SebastianCallh/kartoffel-tsea29/docs/src/anvandarhandledning.pdf

# Anv¨andarhandledning f¨or kartrobot

Patrik Sletmo
Version 1.0

Status

STATUS | Patrik Sletmo | 2016-12-DD

Kartrobot | 2016-12-13

# Projektidentitet

Grupp 3, 16/HT, KarToffel
Link¨opings tekniska h¨ogskola, ISY
Namn | Ansvar | Telefon | E-post
Patrik Sletmo | Projektledare | 070 783 57 61 | patsl736@student.liu.se
Rebecca Lindblom | Utvecklare | 073 436 40 79 | rebli156@student.liu.se
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
