SebastianCallh/kartoffel-tsea29/docs/src/images/robot.png

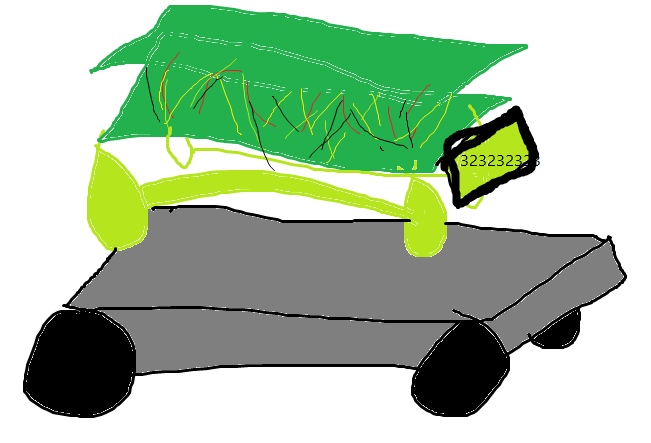
docs/src/images/robot.png
