SebastianCallh/kartoffel-tsea29/docs/src/mjukvaruklient_flowchart3.pdf

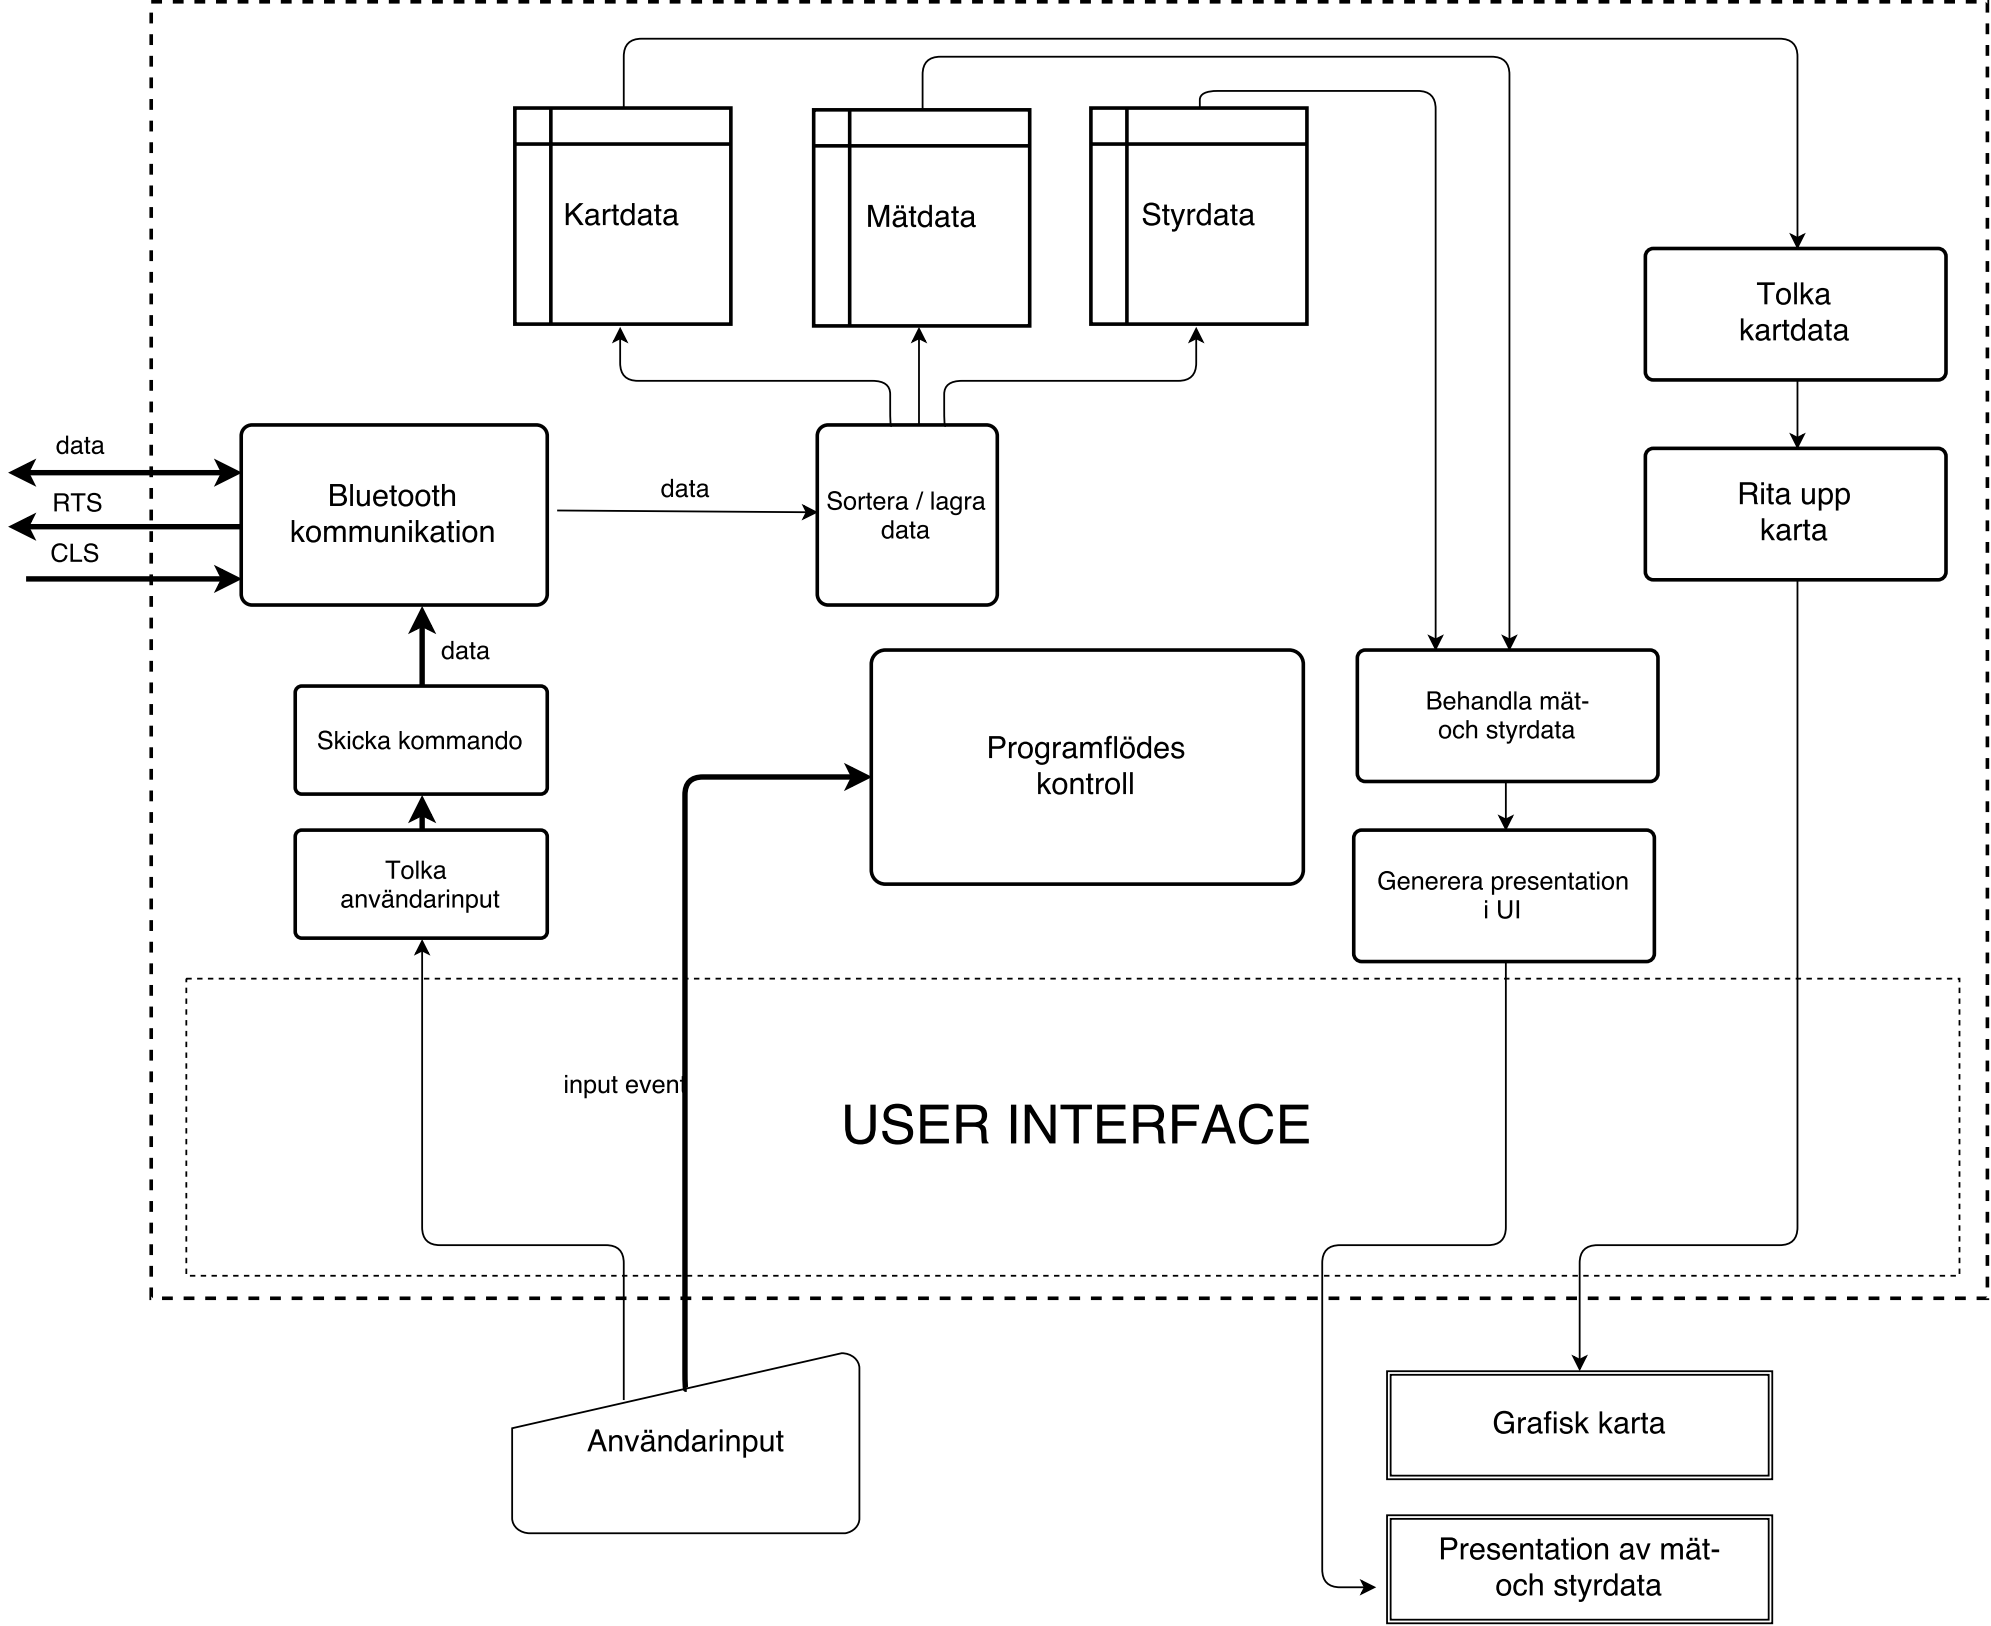
[picture p63: page 1]
