SebastianCallh/kartoffel-tsea29/docs/src/images/Huvudenhet_kopplingsschema.pdf

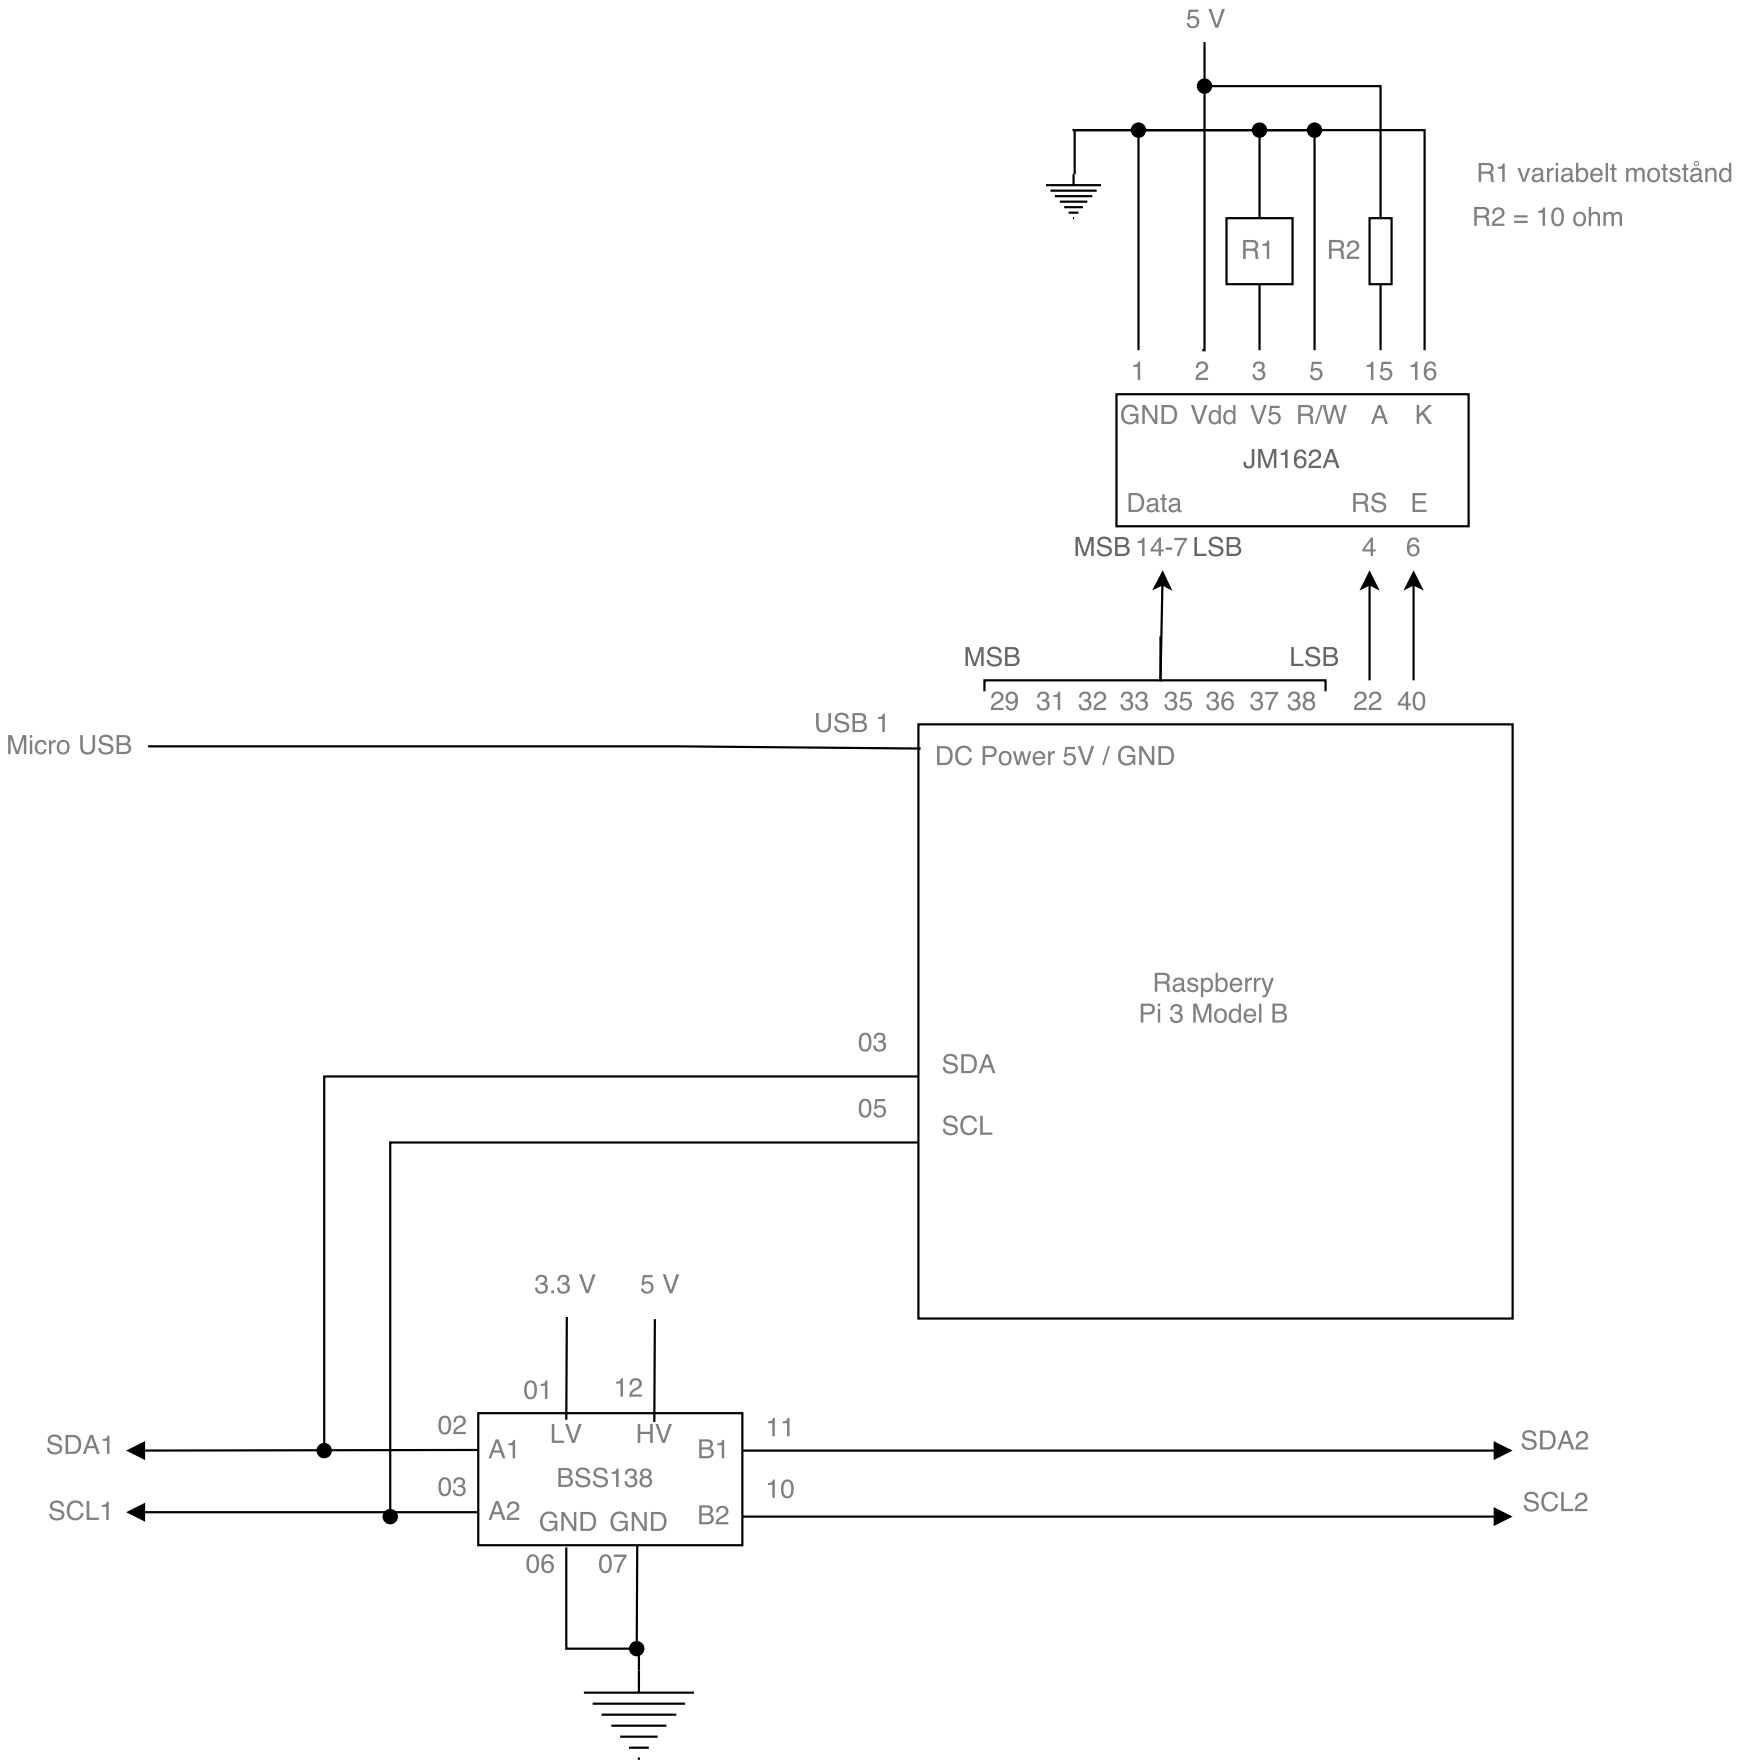
[picture p64: page 1]
