SebastianCallh/kartoffel-tsea29/docs/src/images/Sensorenhet_kopplingsschema.pdf

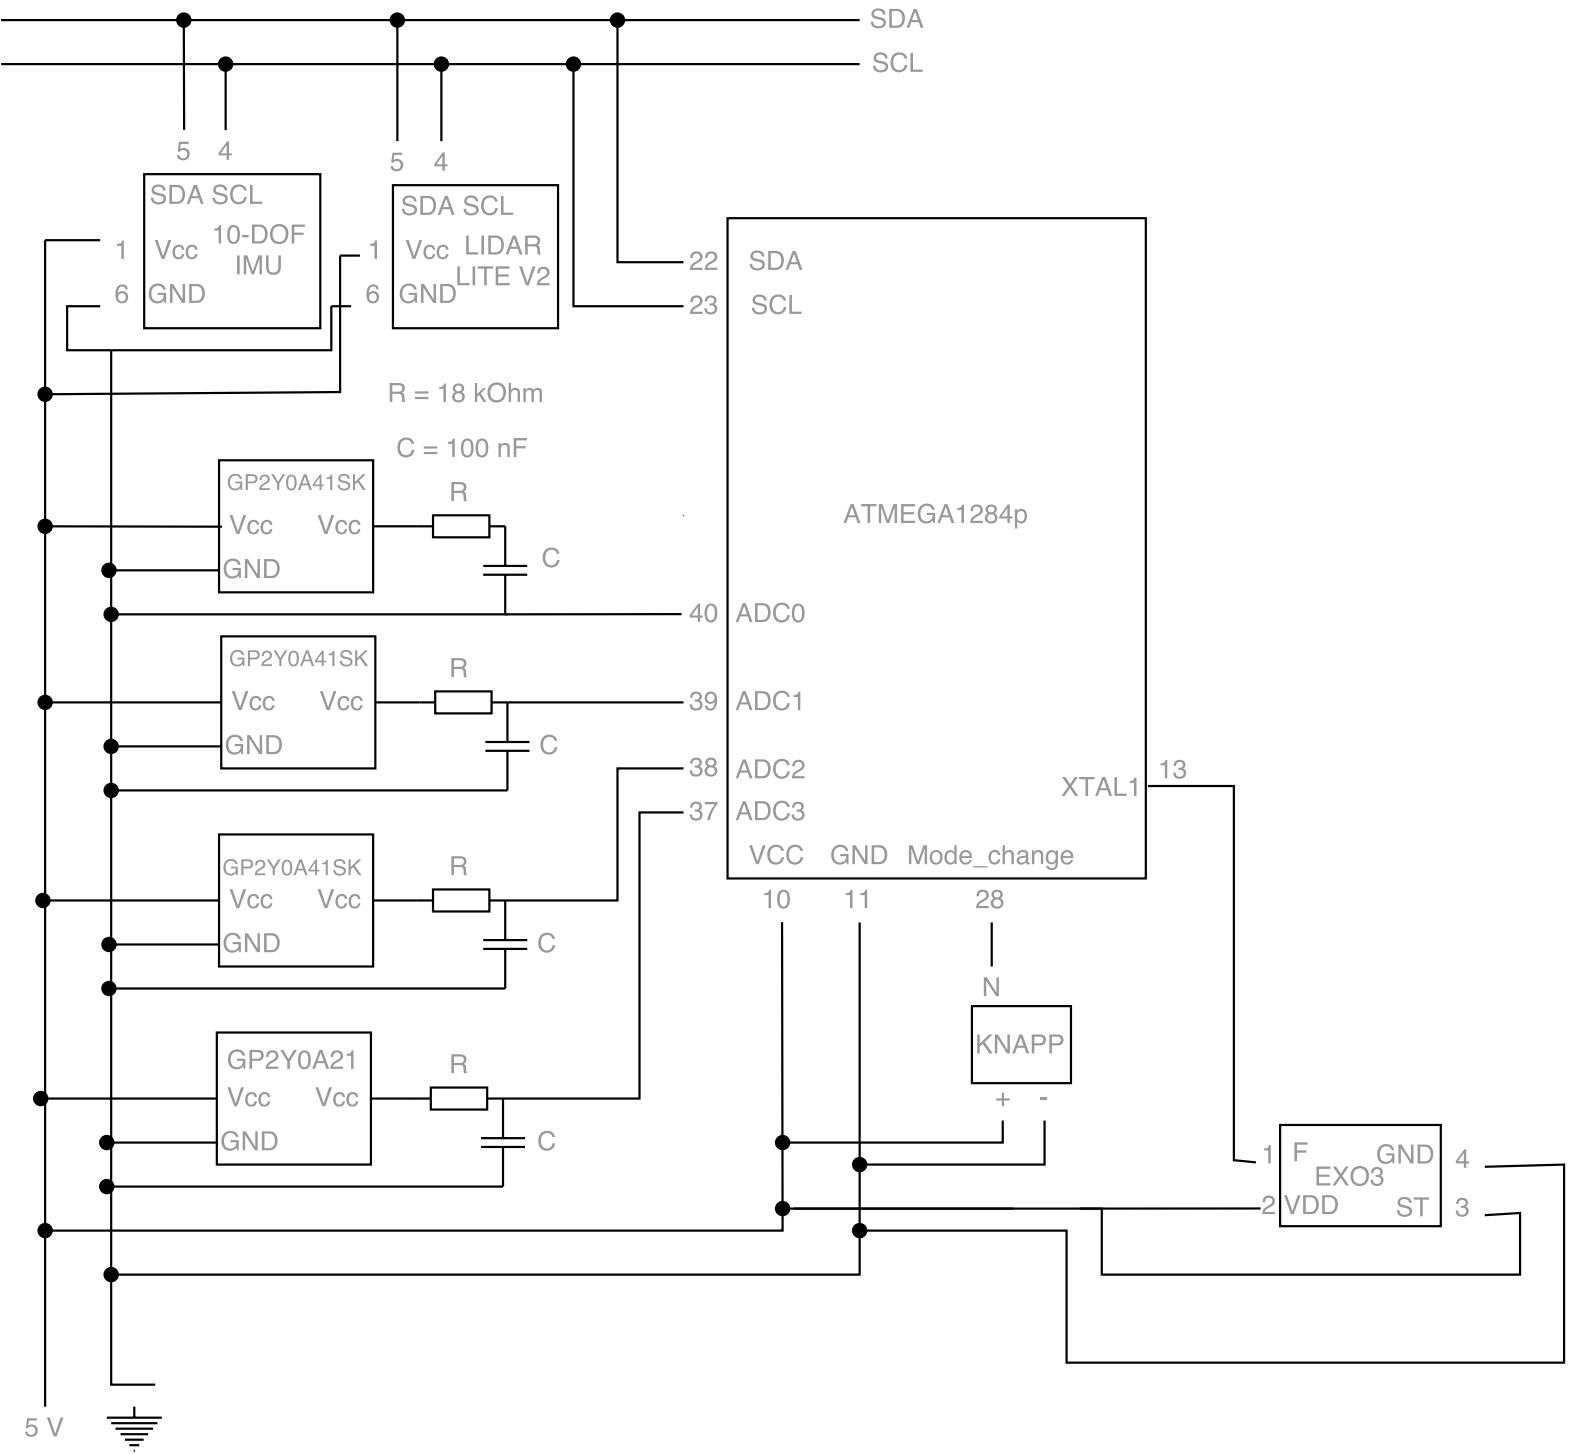
[picture p65: page 1]
