SebastianCallh/kartoffel-tsea29/docs/src/images/software_client_flowchart.pdf

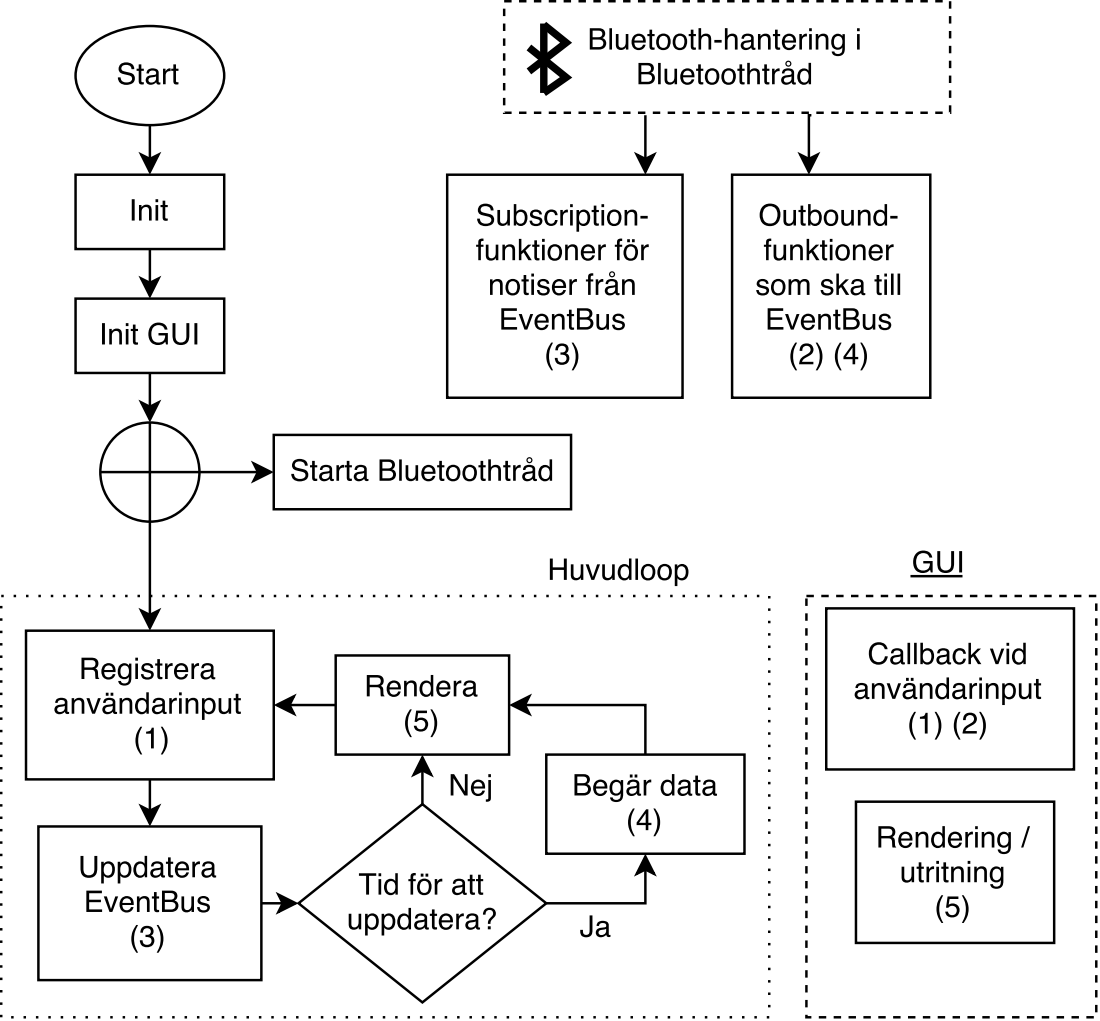
[picture p66: page 1]
