SebastianCallh/kartoffel-tsea29/docs/src/images/bt-flow-main-unit.pdf

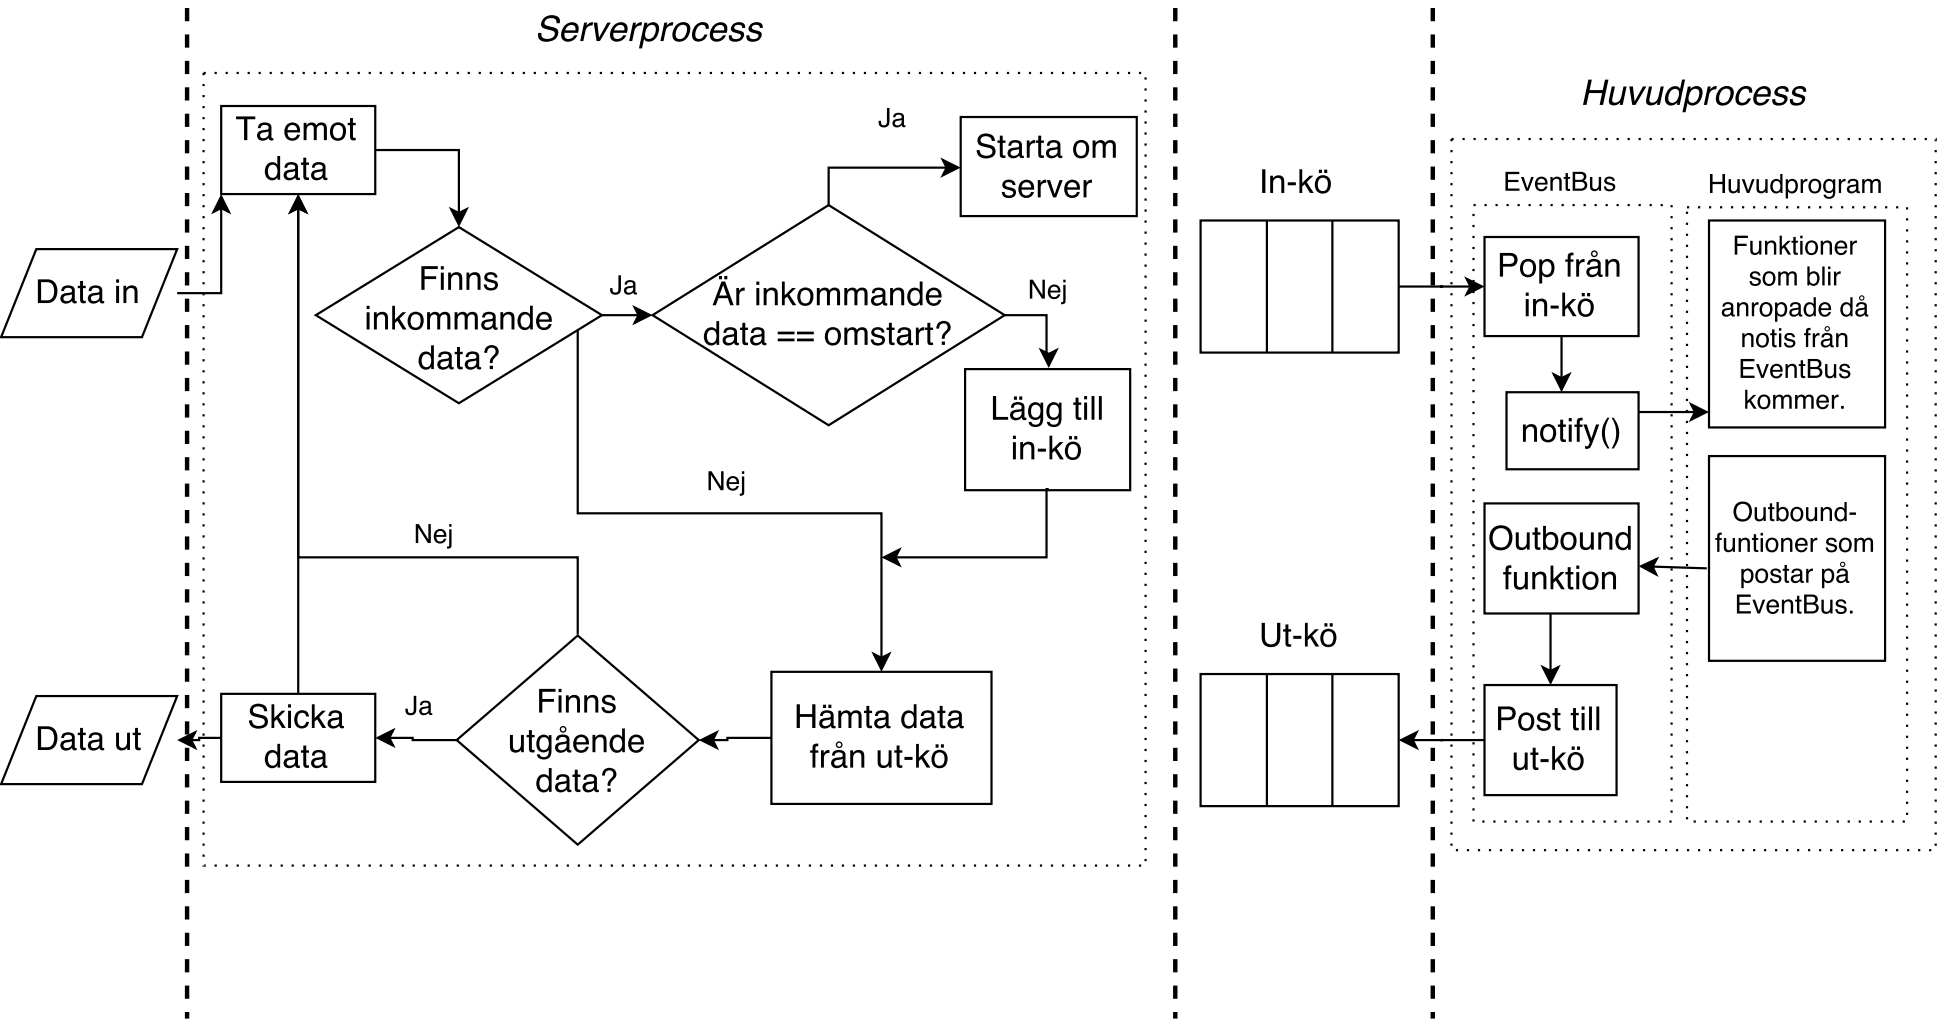
[picture p67: page 1]
