SebastianCallh/kartoffel-tsea29/docs/src/images/bt-flow-software-client.pdf

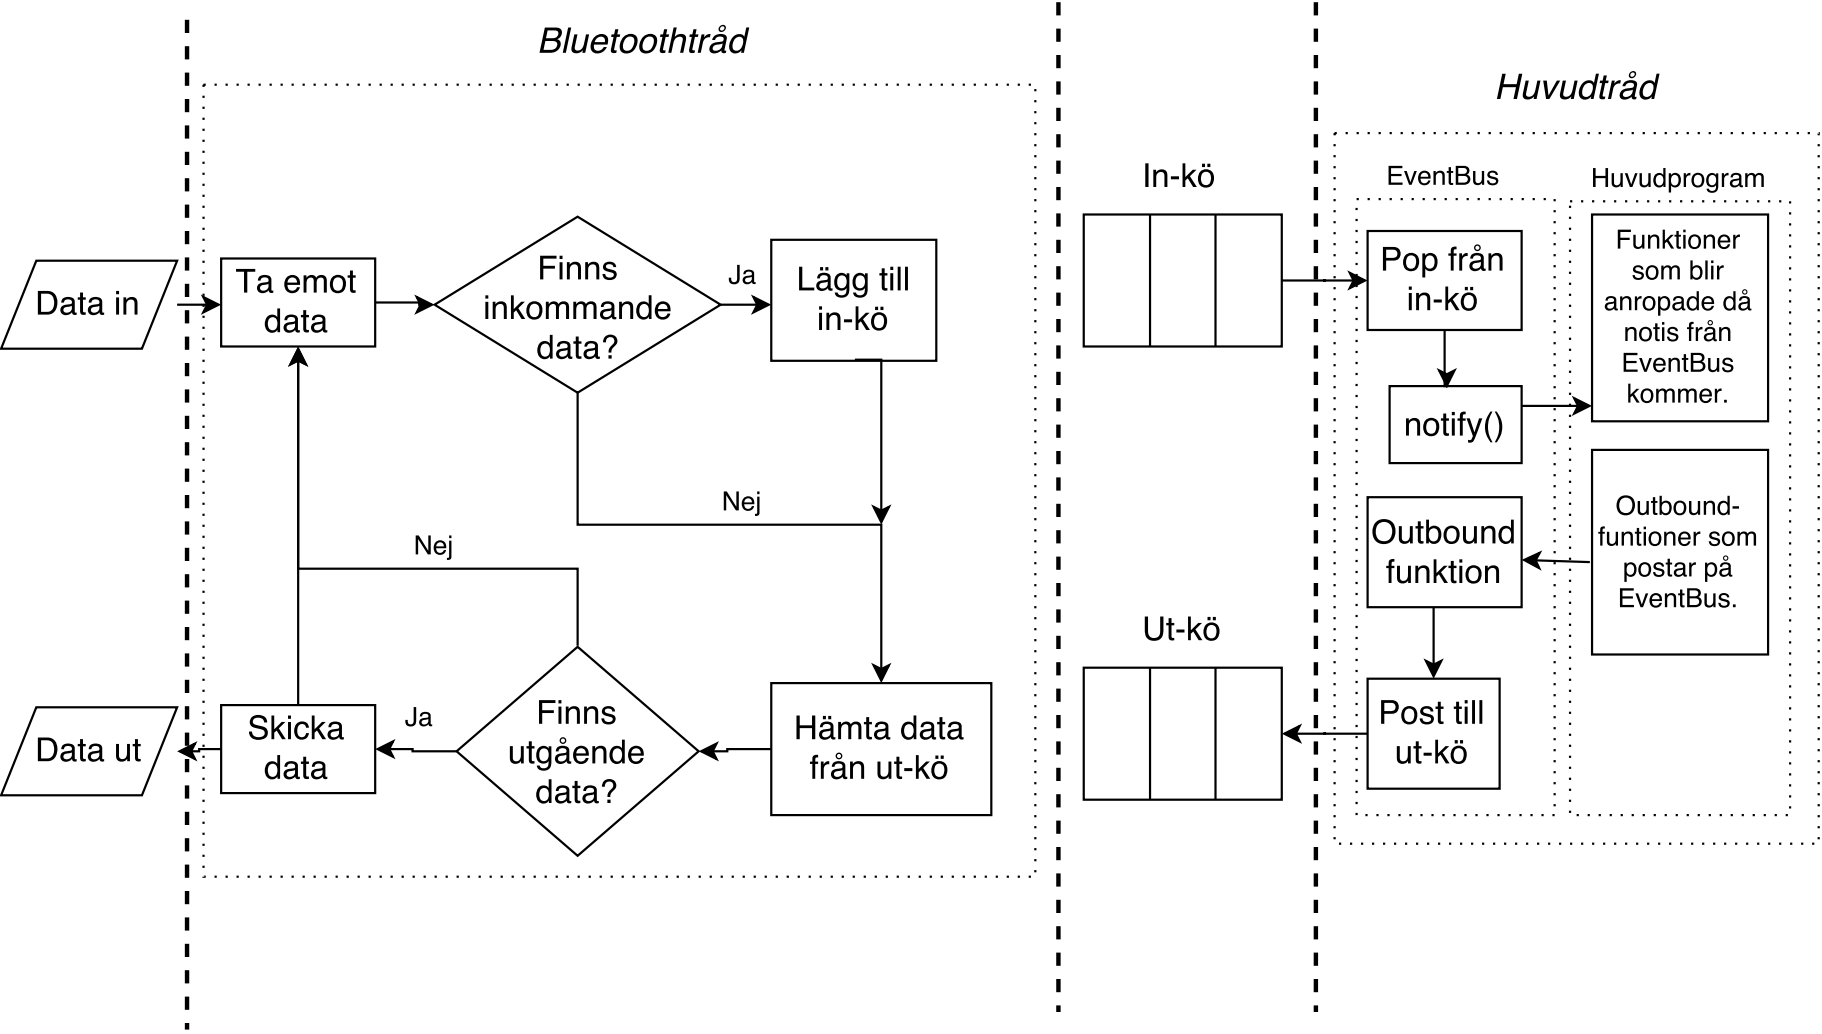
[picture p68: page 1]
