SebastianCallh/kartoffel-tsea29/docs/src/images/mjukvarumoduler.pdf

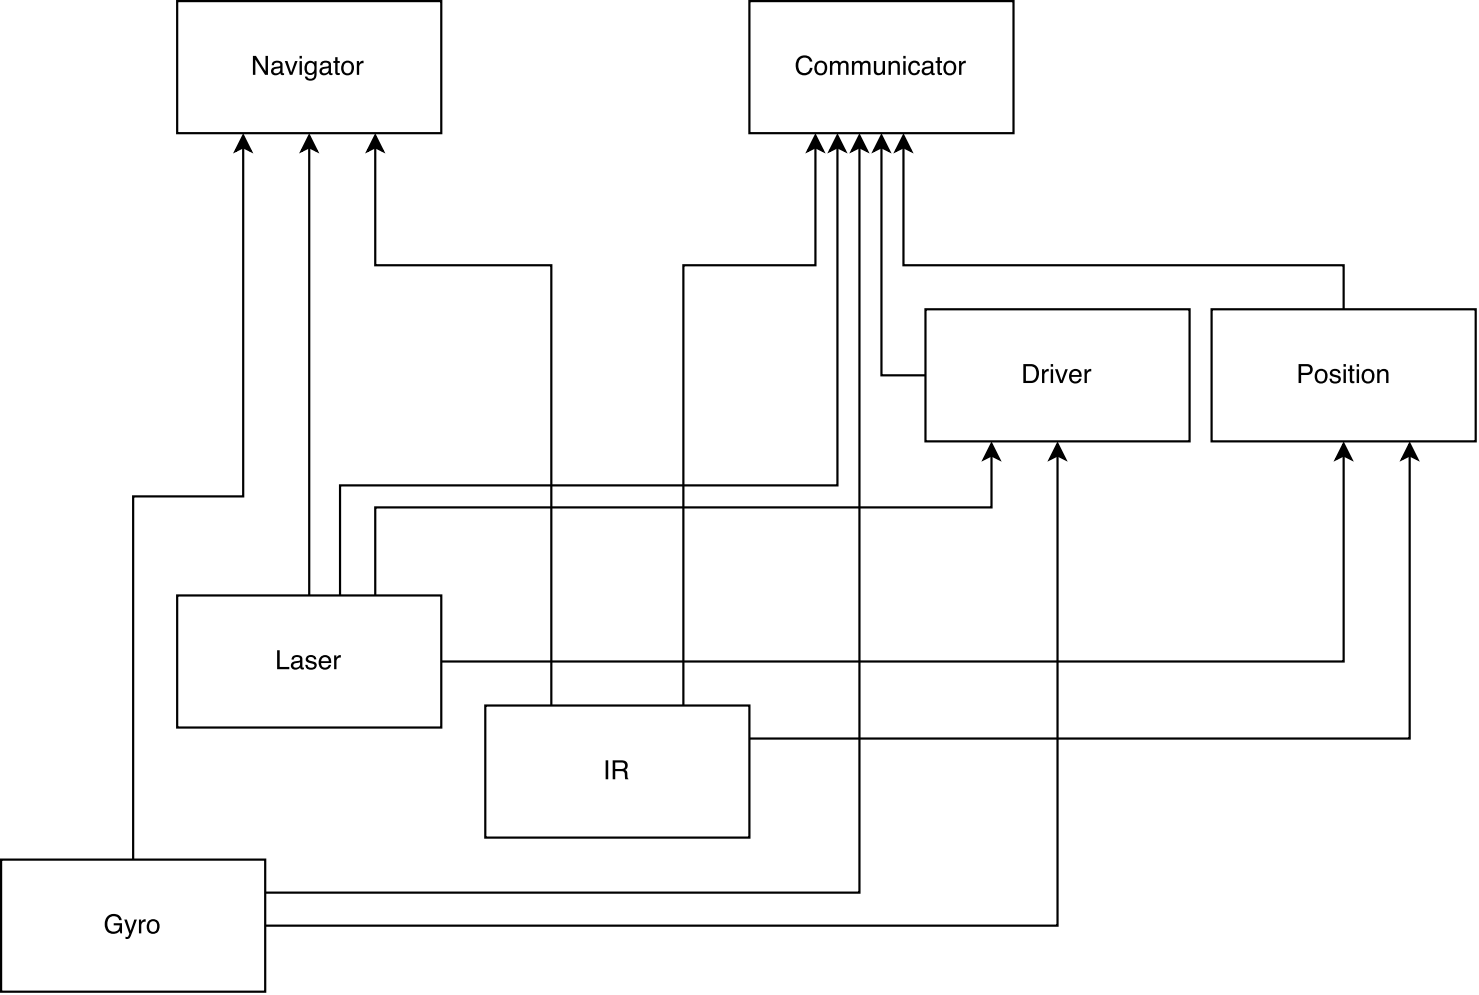
[picture p69: page 1]
