SebastianCallh/kartoffel-tsea29/docs/src/images/navigation_dead_end.pdf

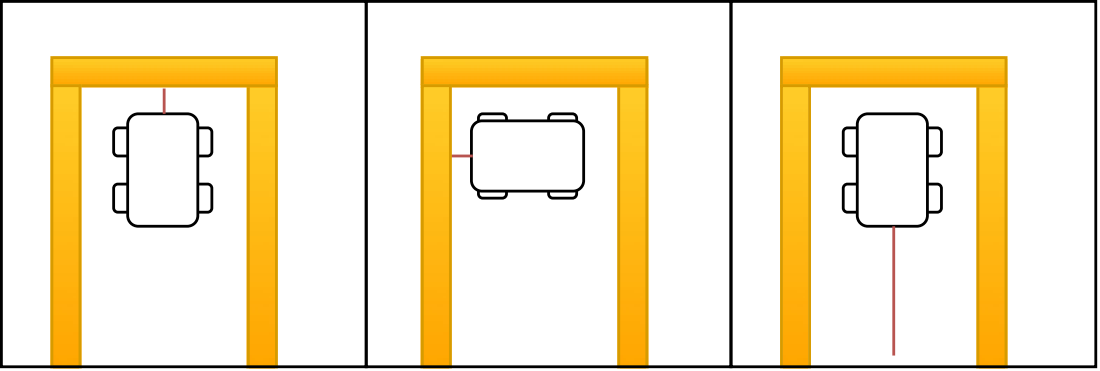
[picture p70: page 1]
