SebastianCallh/kartoffel-tsea29/docs/src/images/navigation_inner_turn.pdf

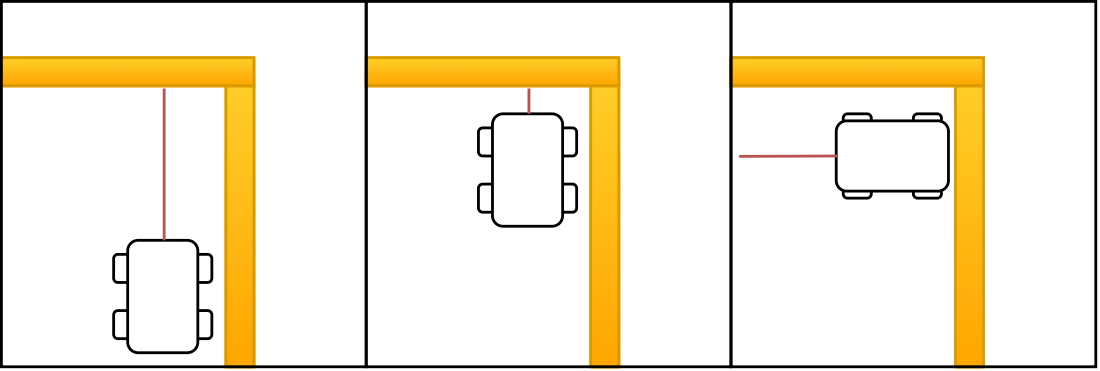
[picture p71: page 1]
