SebastianCallh/kartoffel-tsea29/docs/src/images/navigation_outer_turn.pdf

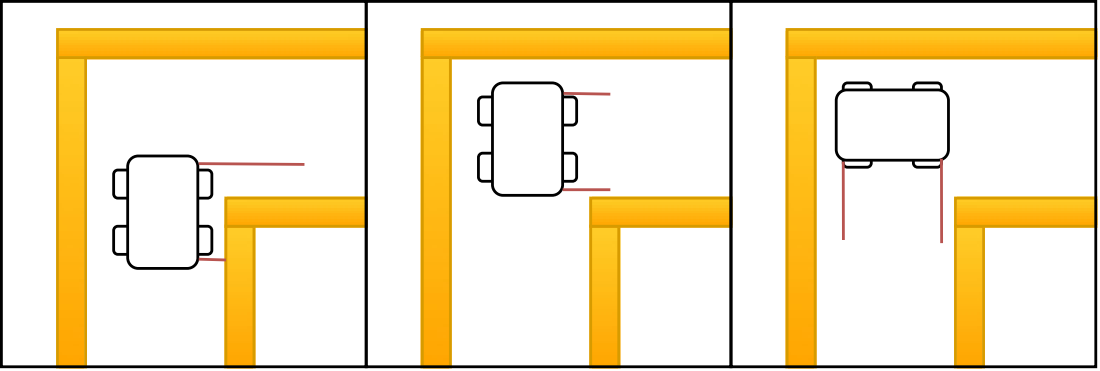
[picture p72: page 1]
