SebastianCallh/kartoffel-tsea29/docs/src/images/Reglering.pdf

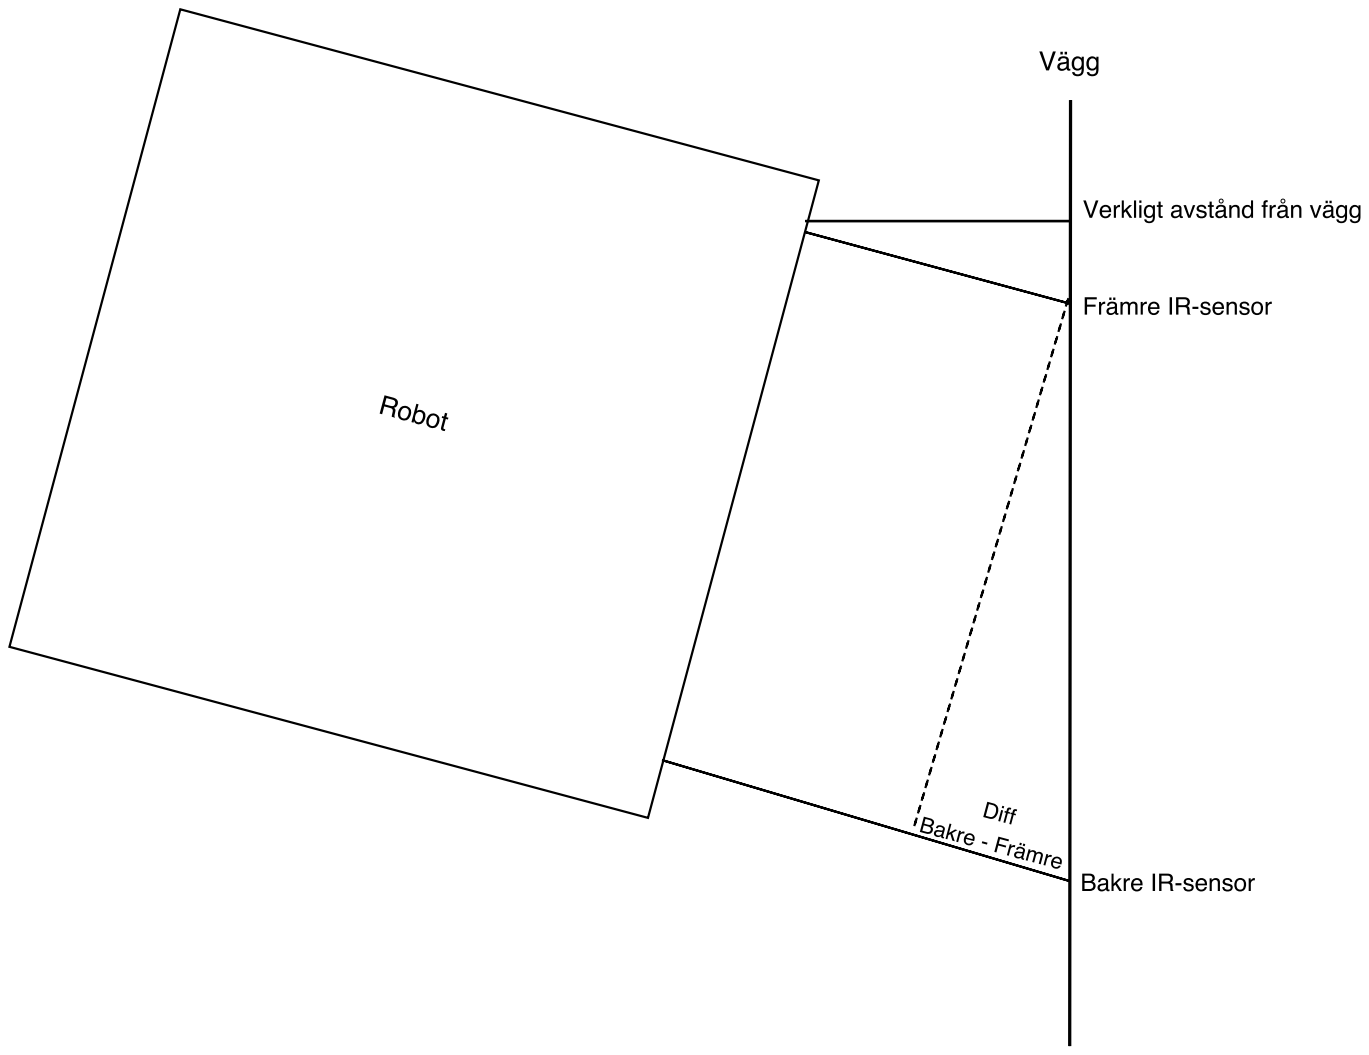
[picture p73: page 1]
