SebastianCallh/kartoffel-tsea29/docs/src/images/Styrenhet_kopplingsschema.pdf

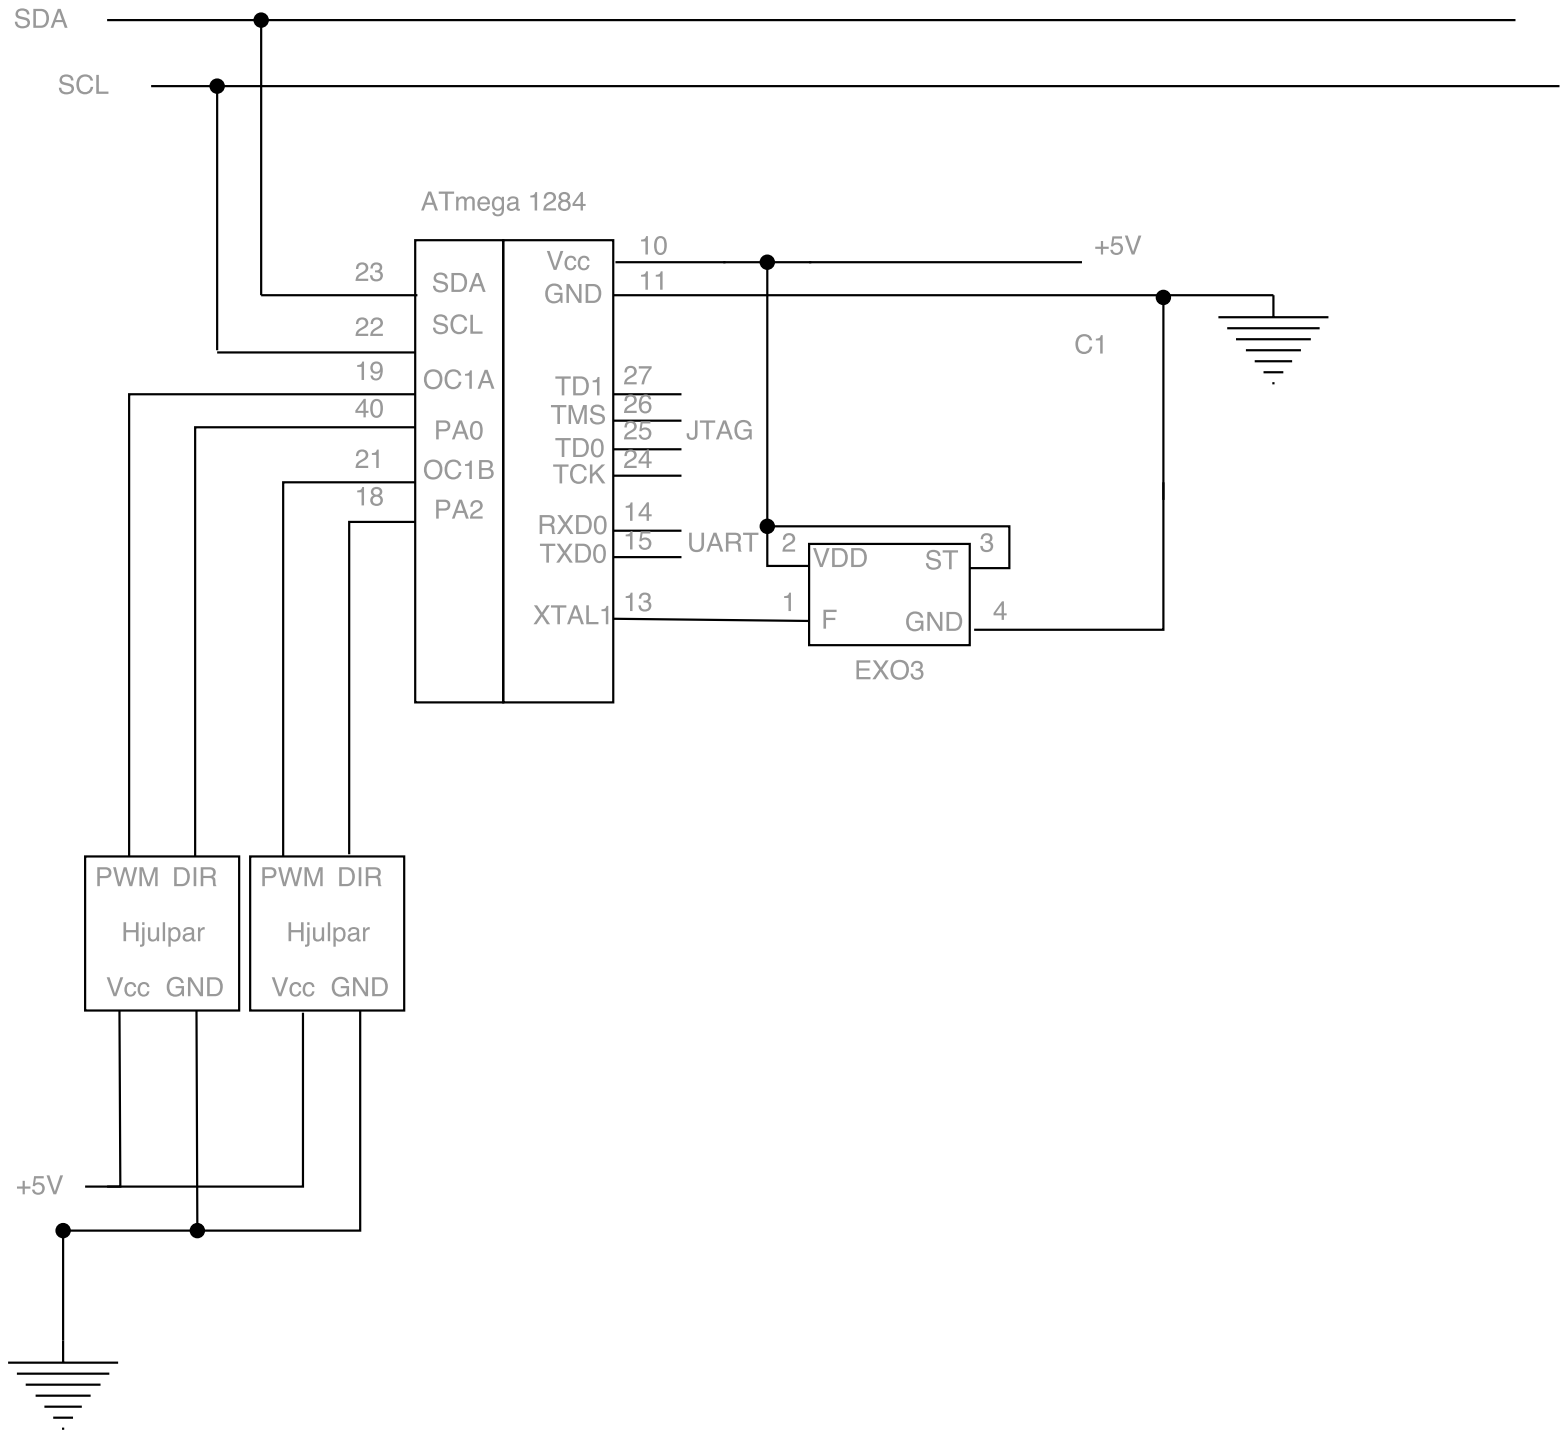
[picture p74: page 1]
