SebastianCallh/kartoffel-tsea29/docs/src/images/Huvudbuss.pdf

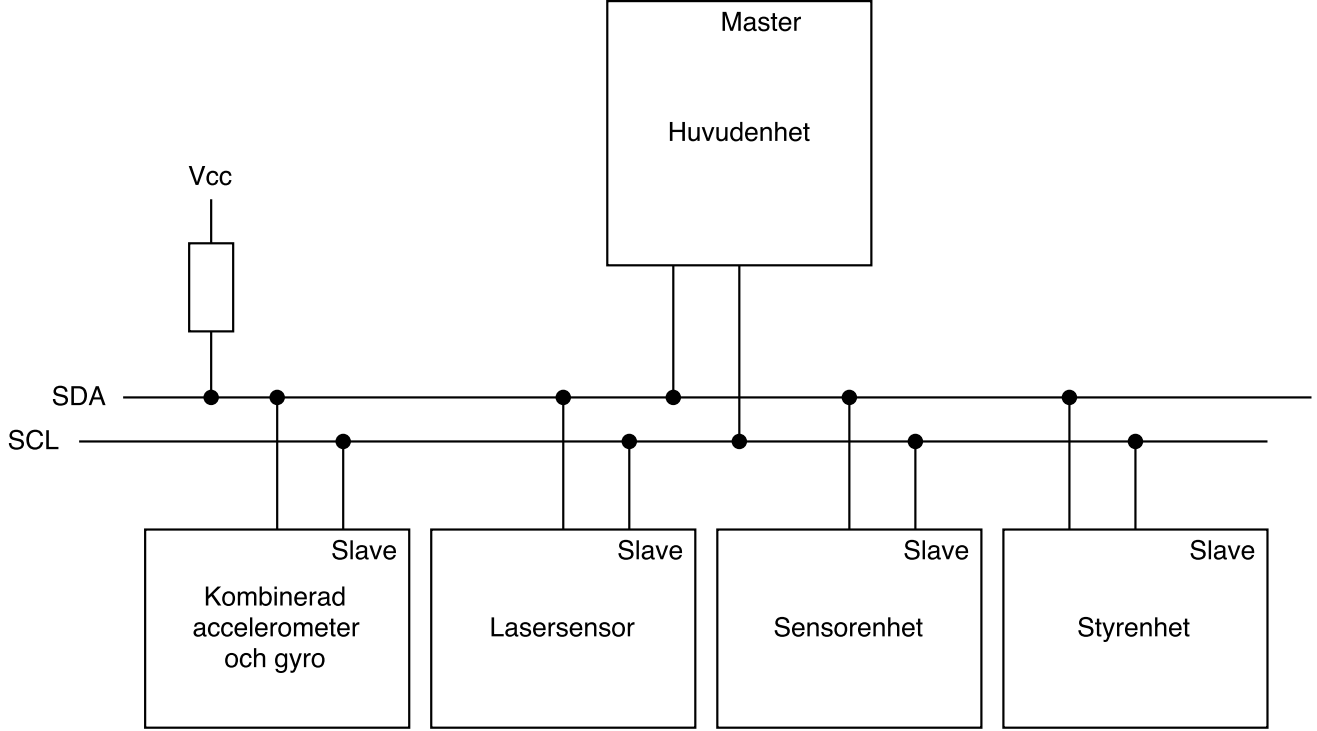
[picture p75: page 1]
