SebastianCallh/kartoffel-tsea29/docs/src/images/Kommunikation_huvudenhet_v2.pdf

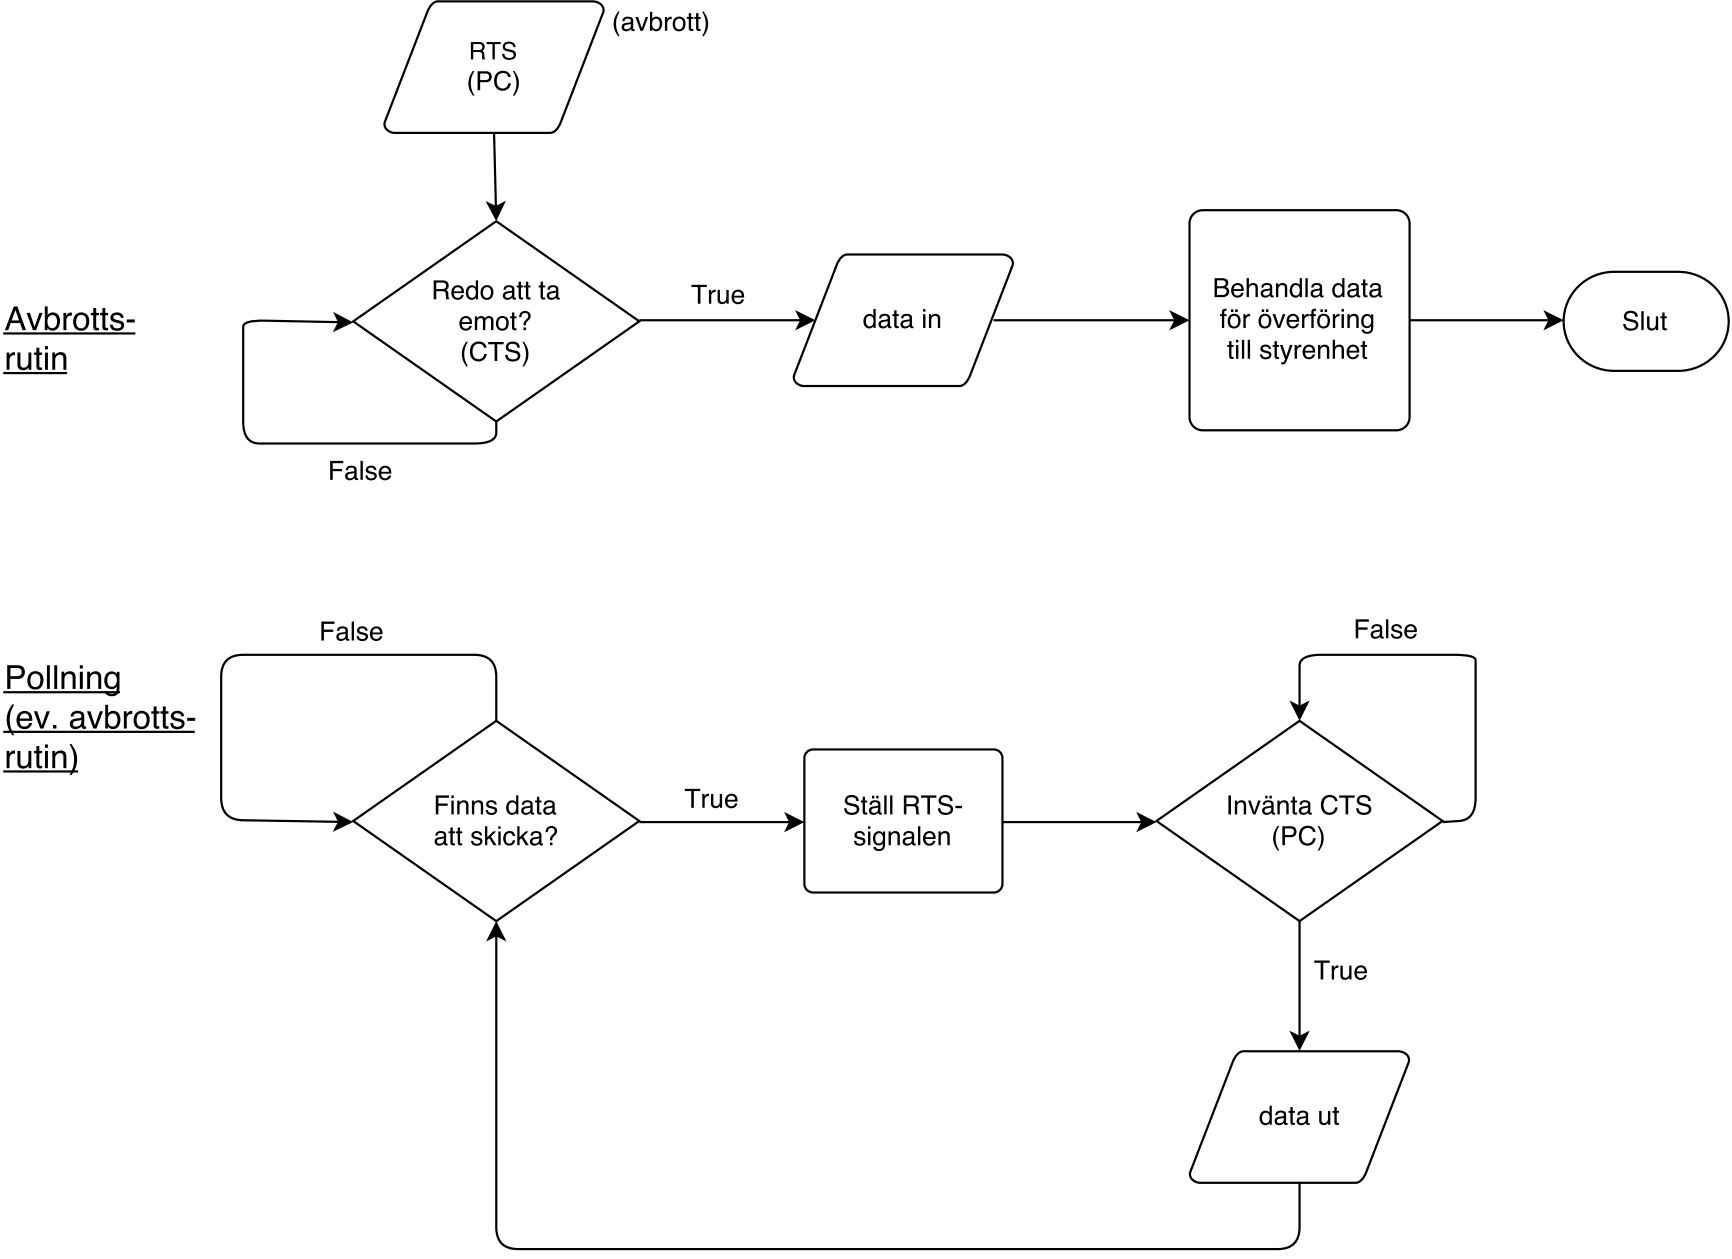
[picture p76: page 1]
