SebastianCallh/kartoffel-tsea29/docs/src/images/navigering_flowchart.pdf

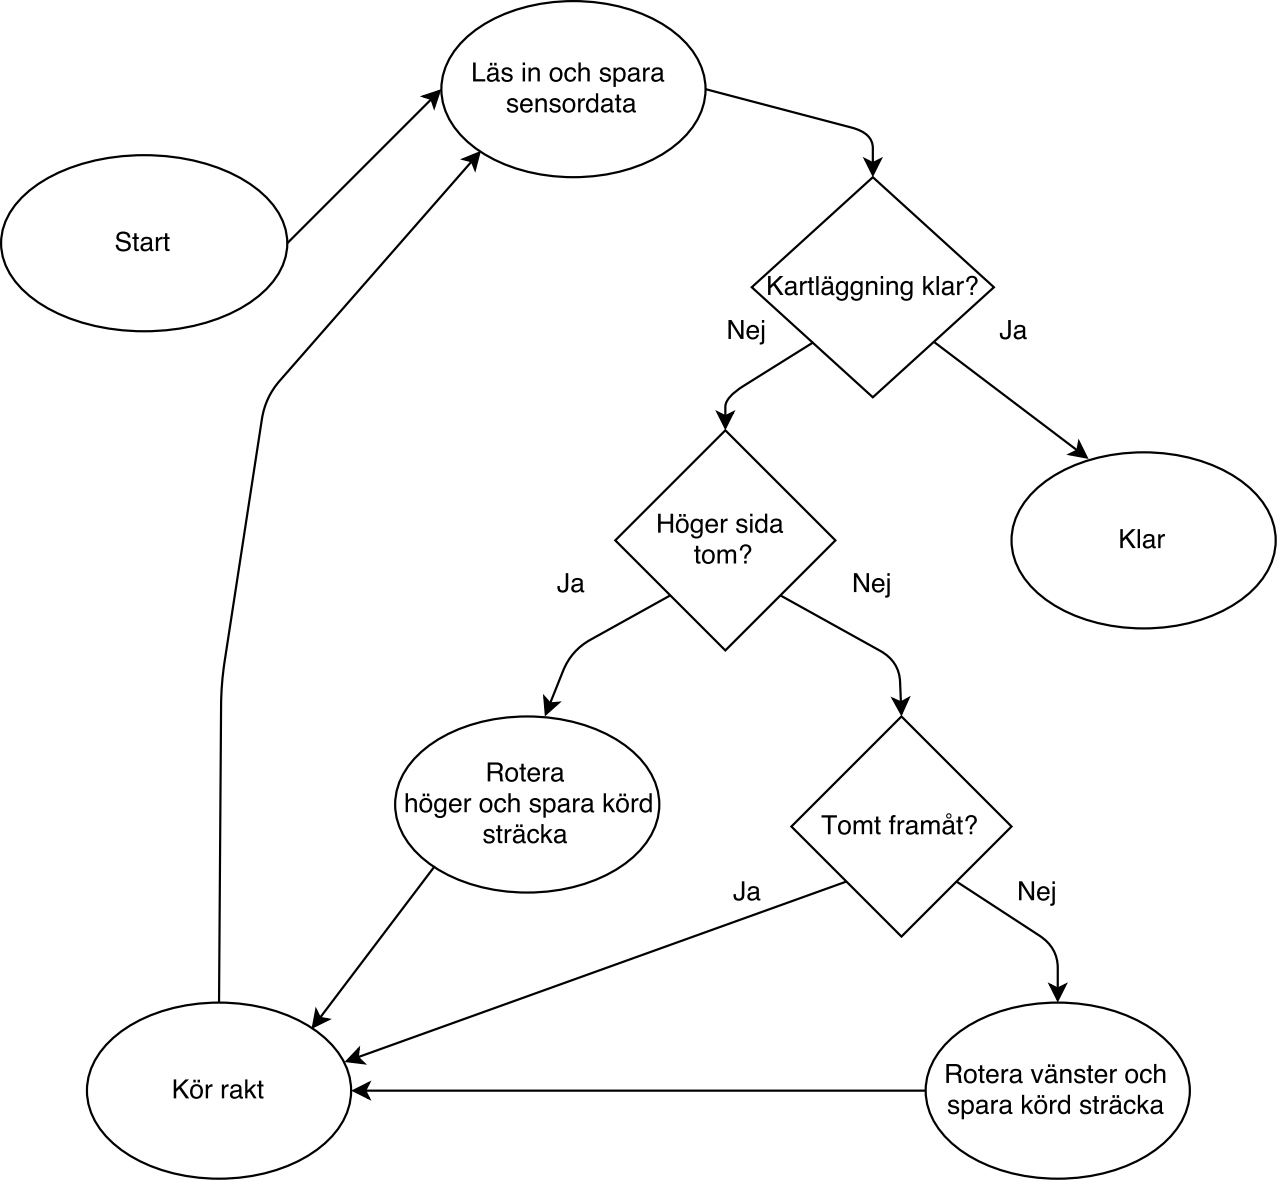
[picture p77: page 1]
