SebastianCallh/kartoffel-tsea29/docs/src/images/oversikt_systemet3.pdf

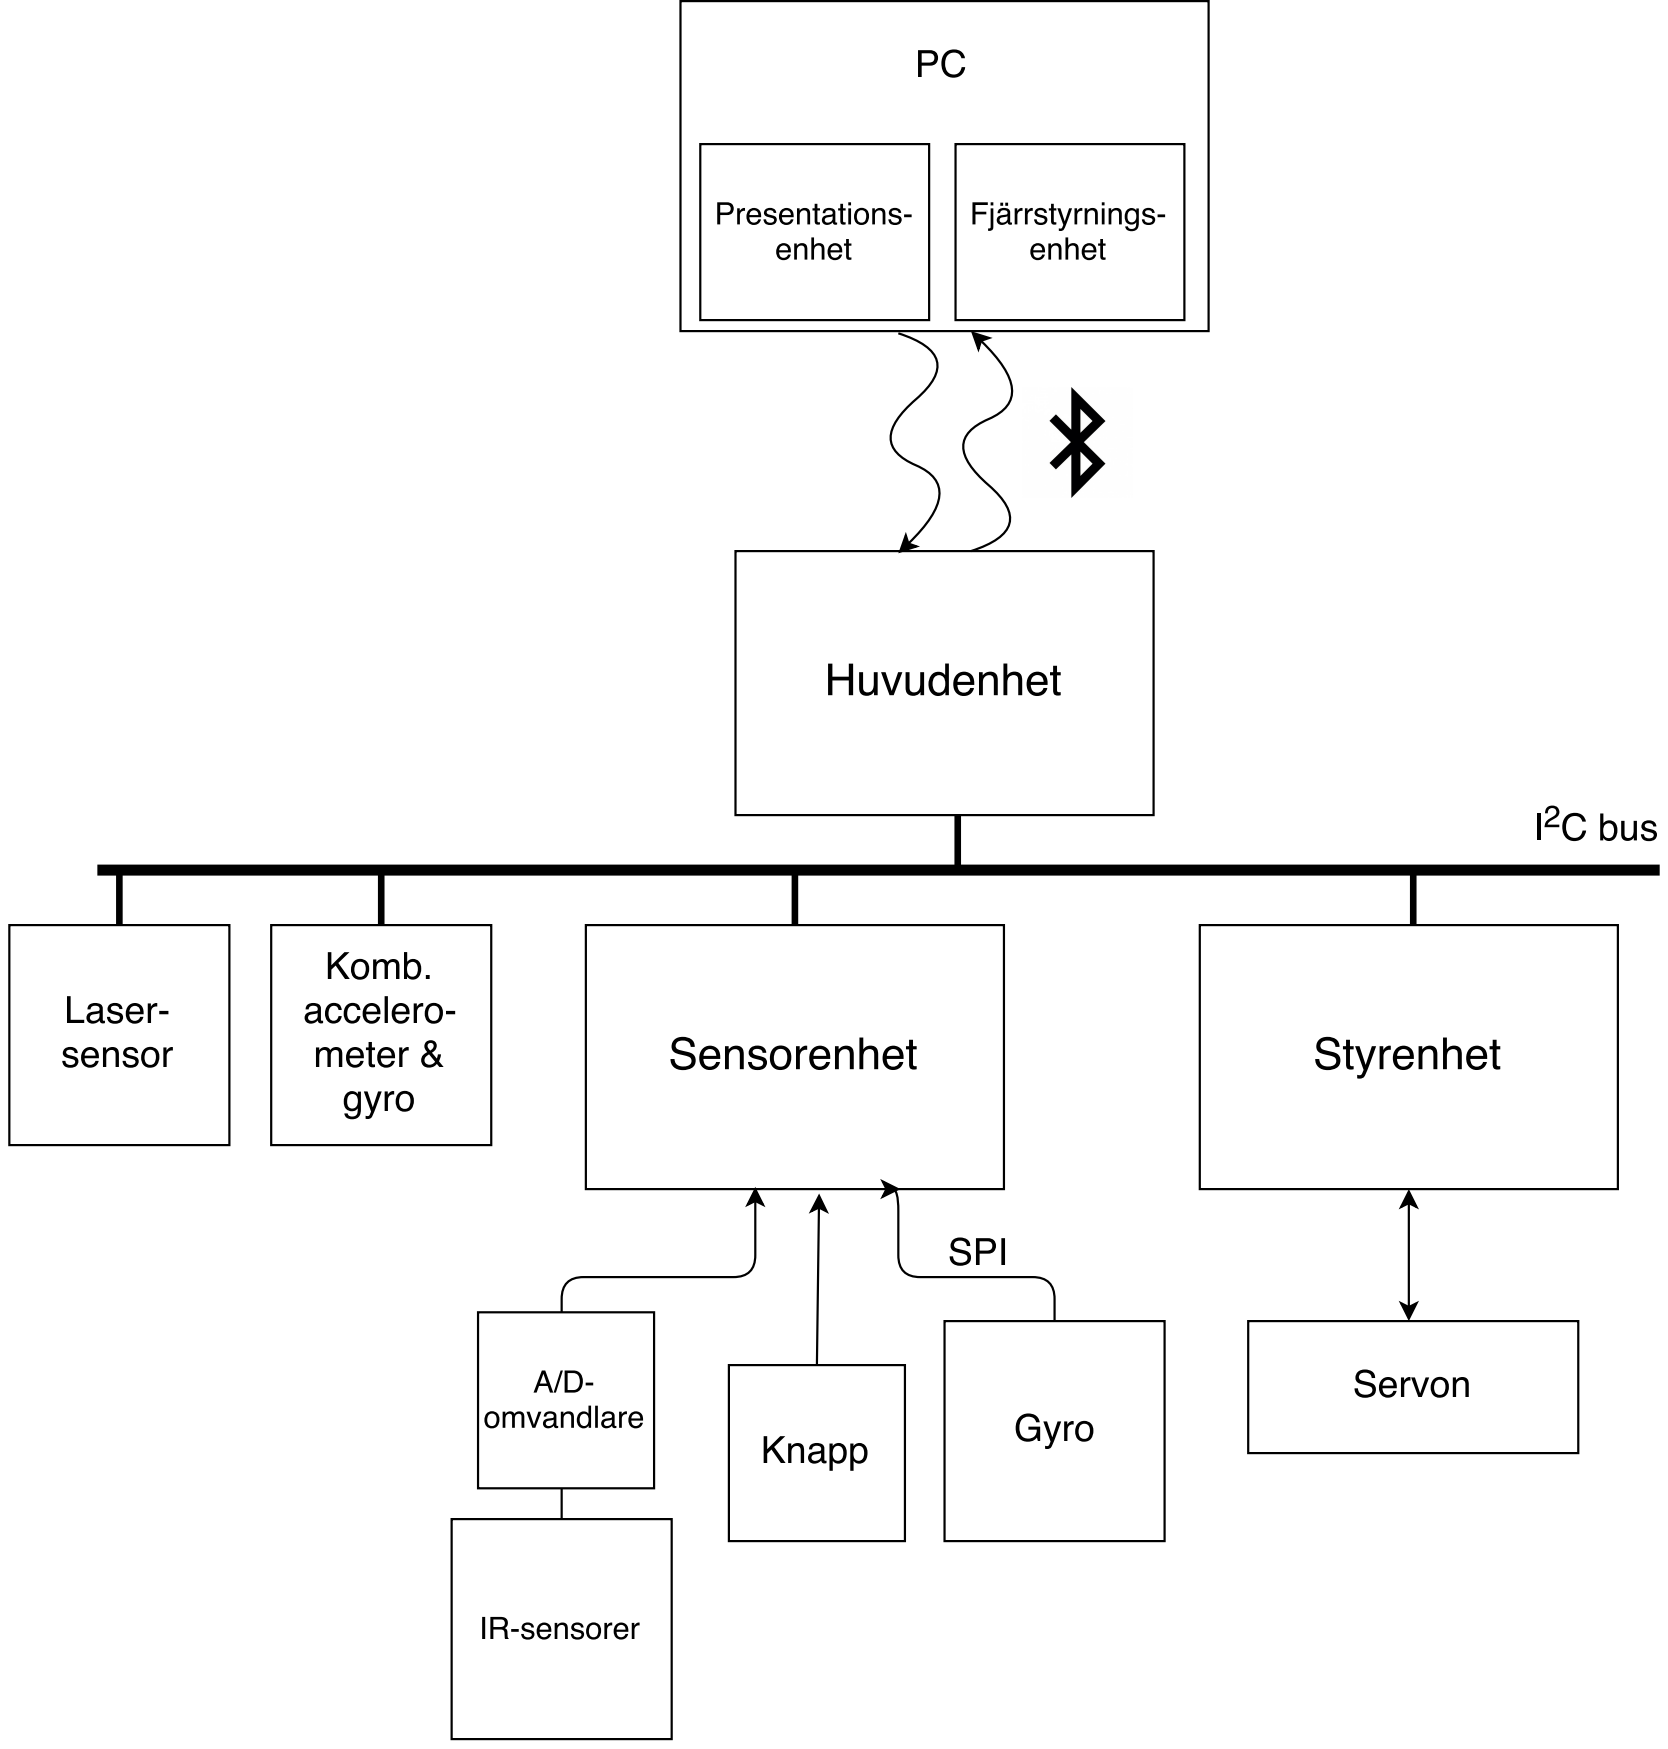
[picture p78: page 1]
