SebastianCallh/kartoffel-tsea29/docs/src/images/Fjarrstyrningsenhet_flowchart3.pdf

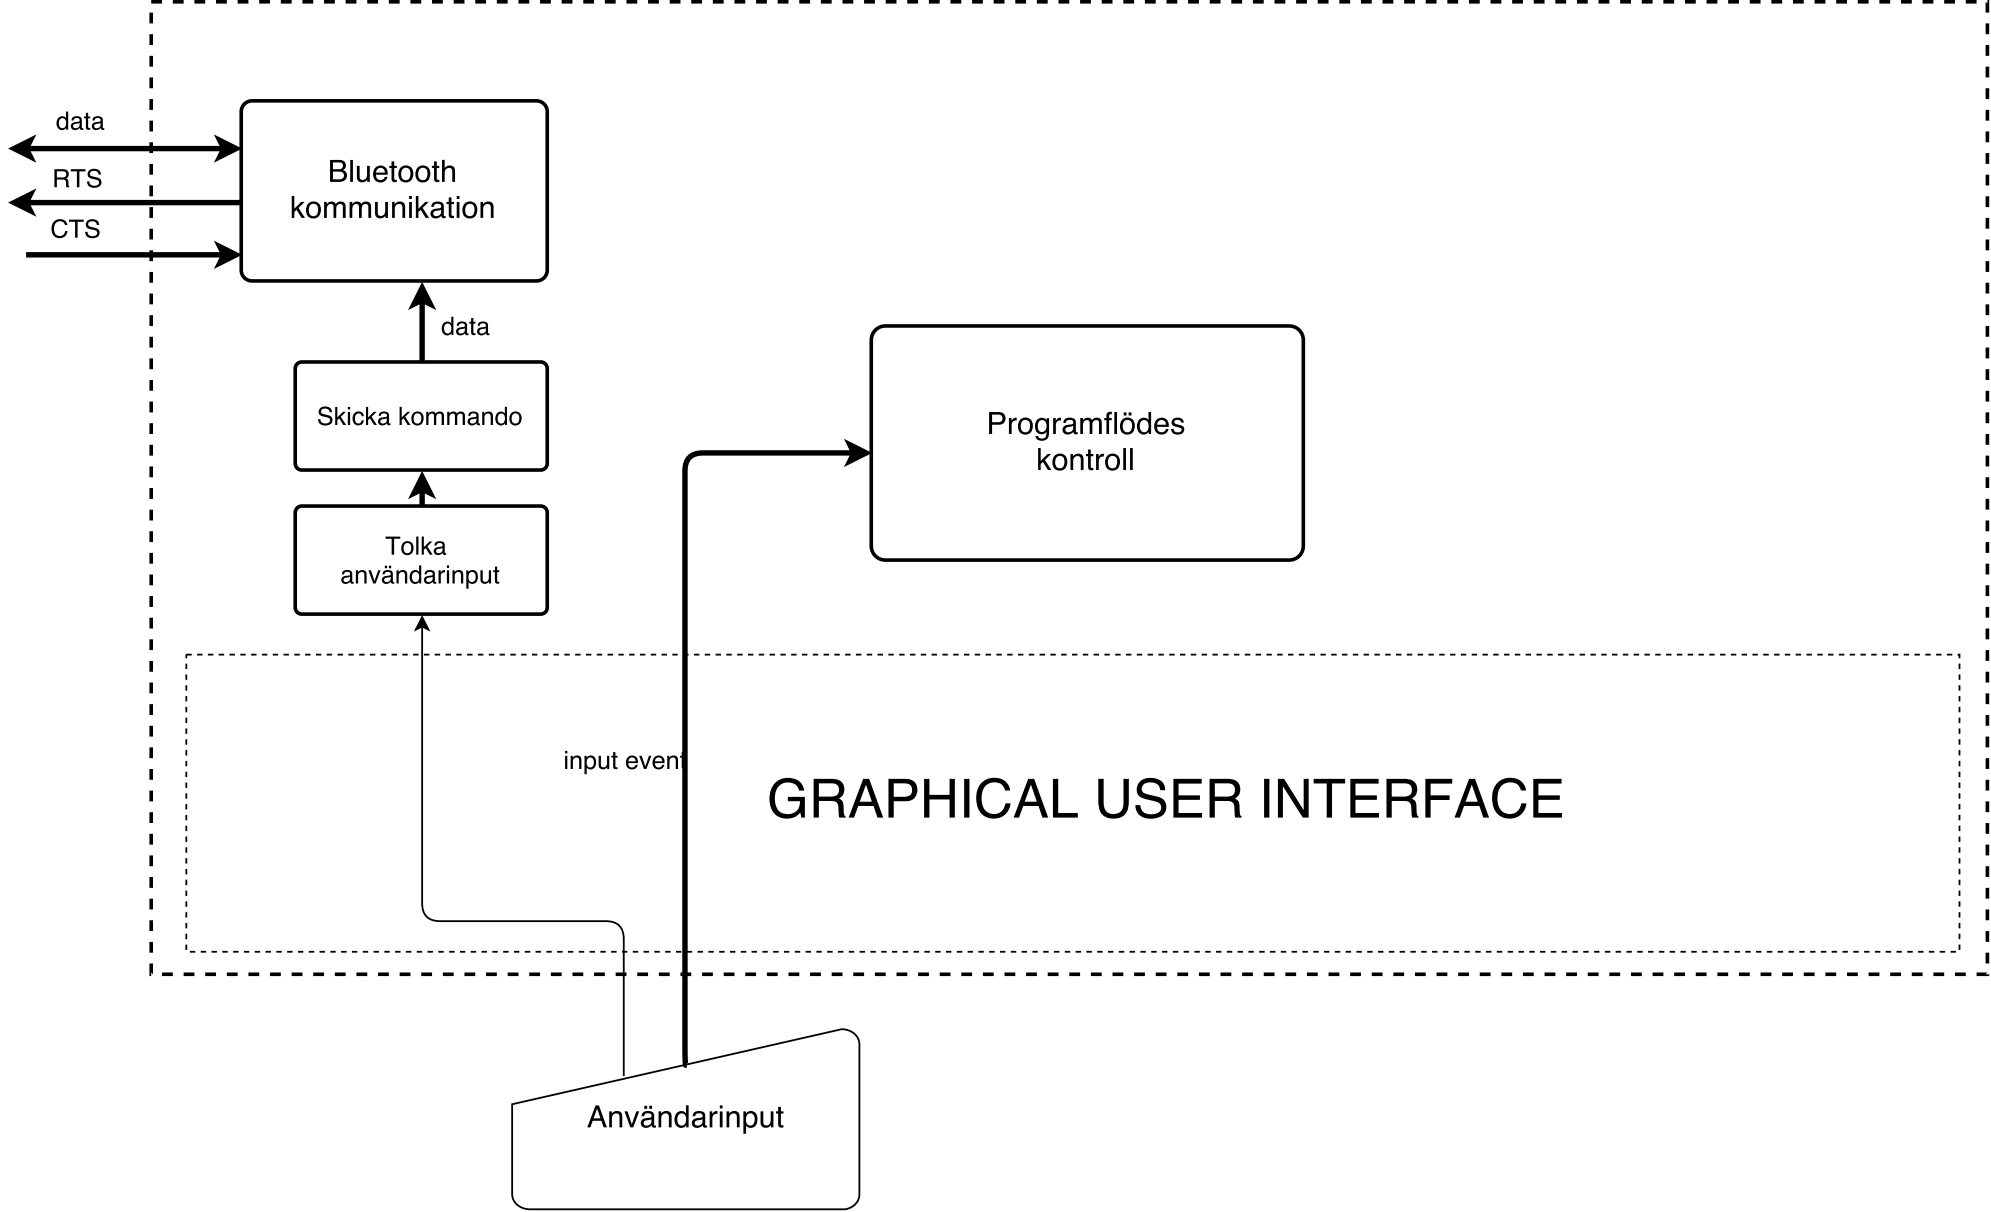
[picture p79: page 1]
