SebastianCallh/kartoffel-tsea29/docs/src/images/Oversikt_fjarrstyrenhet3.pdf

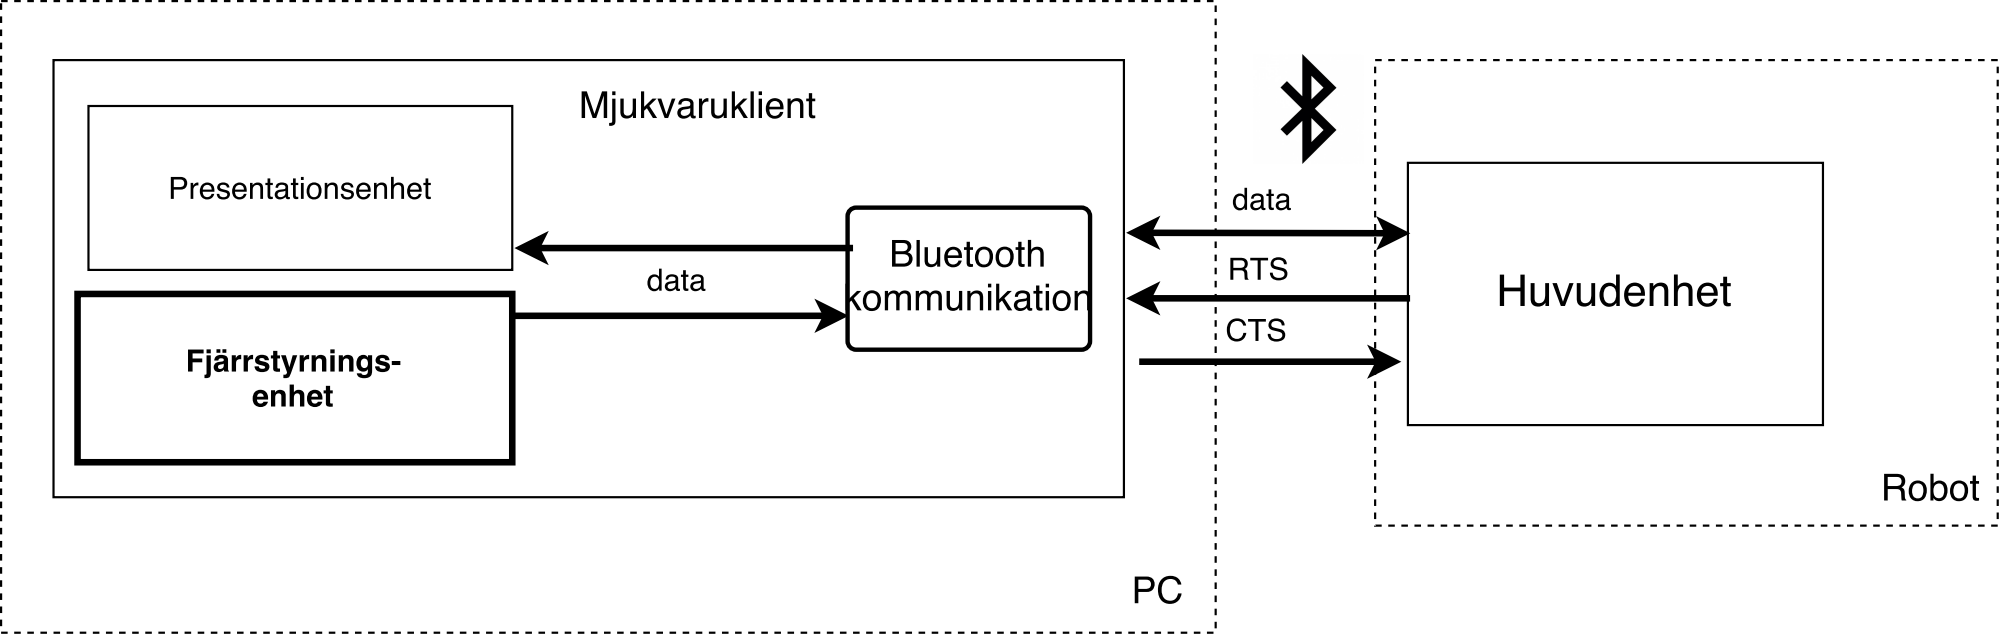
[picture p80: page 1]
