SebastianCallh/kartoffel-tsea29/docs/src/images/Oversikt_presentationsenhet3.pdf

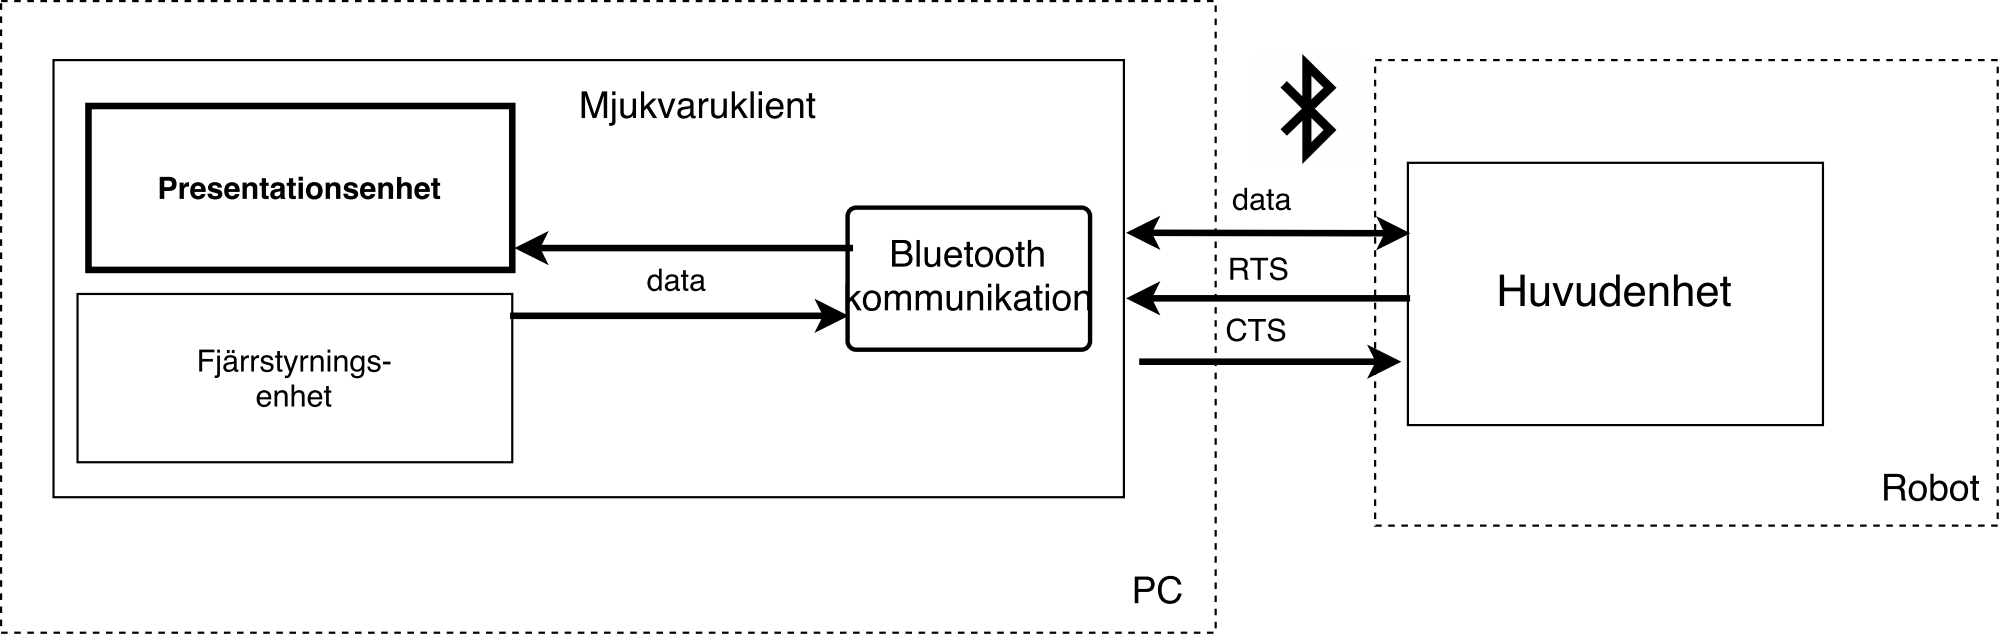
[picture p81: page 1]
