SebastianCallh/kartoffel-tsea29/docs/src/images/Presentationsenhet3.pdf

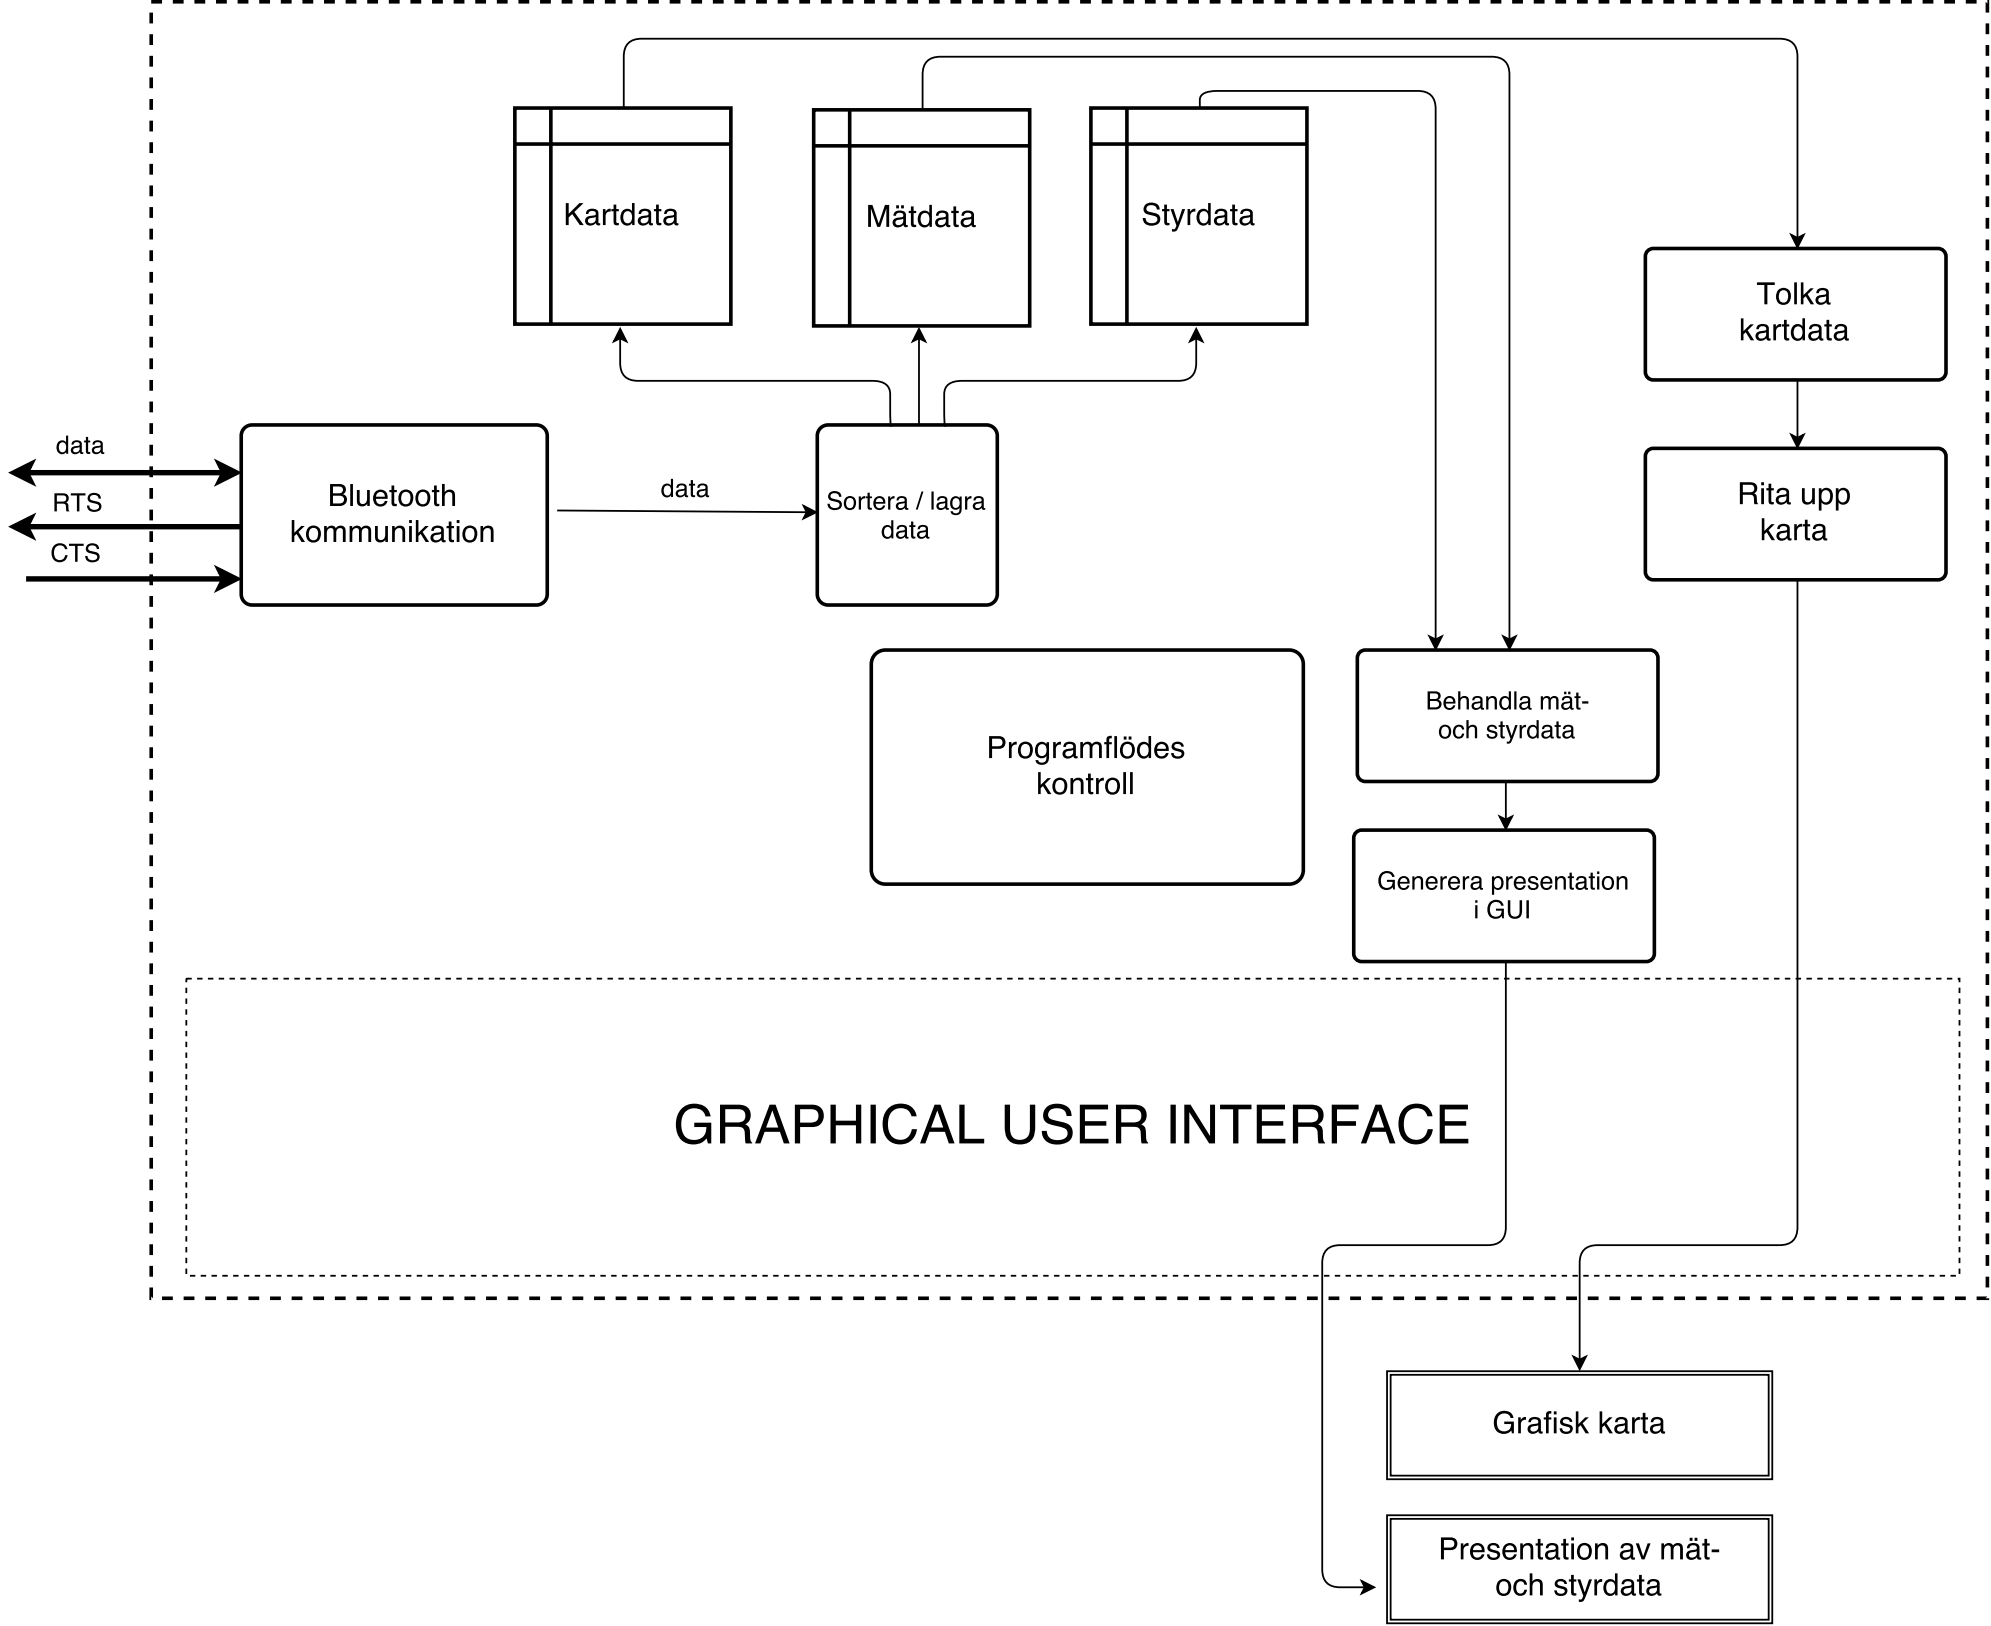
[picture p82: page 1]
