SebastianCallh/kartoffel-tsea29/docs/src/images/Kommunikation_Bluetooth.pdf

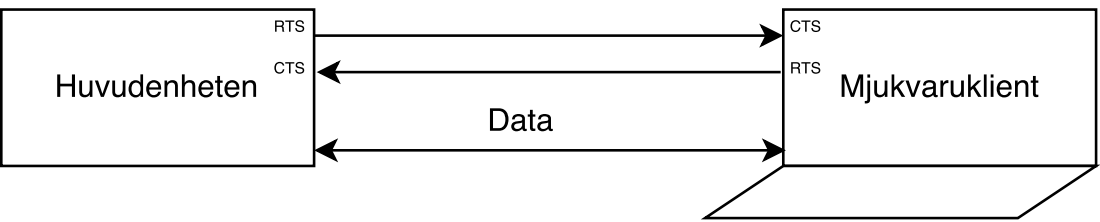
[picture p83: page 1]
