SebastianCallh/kartoffel-tsea29/docs/src/images/sensorenhet_flowchart.pdf

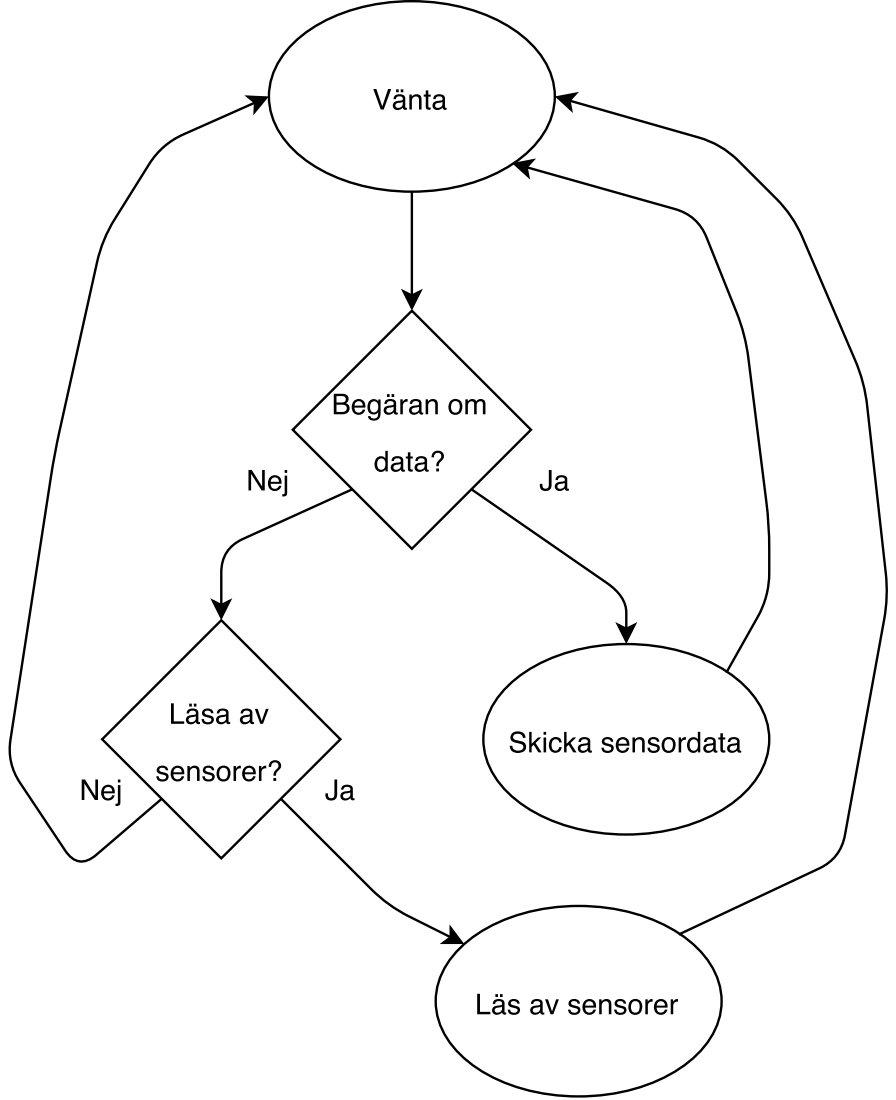
[picture p84: page 1]
