SebastianCallh/kartoffel-tsea29/docs/src/images/oversikt_systemet2.pdf

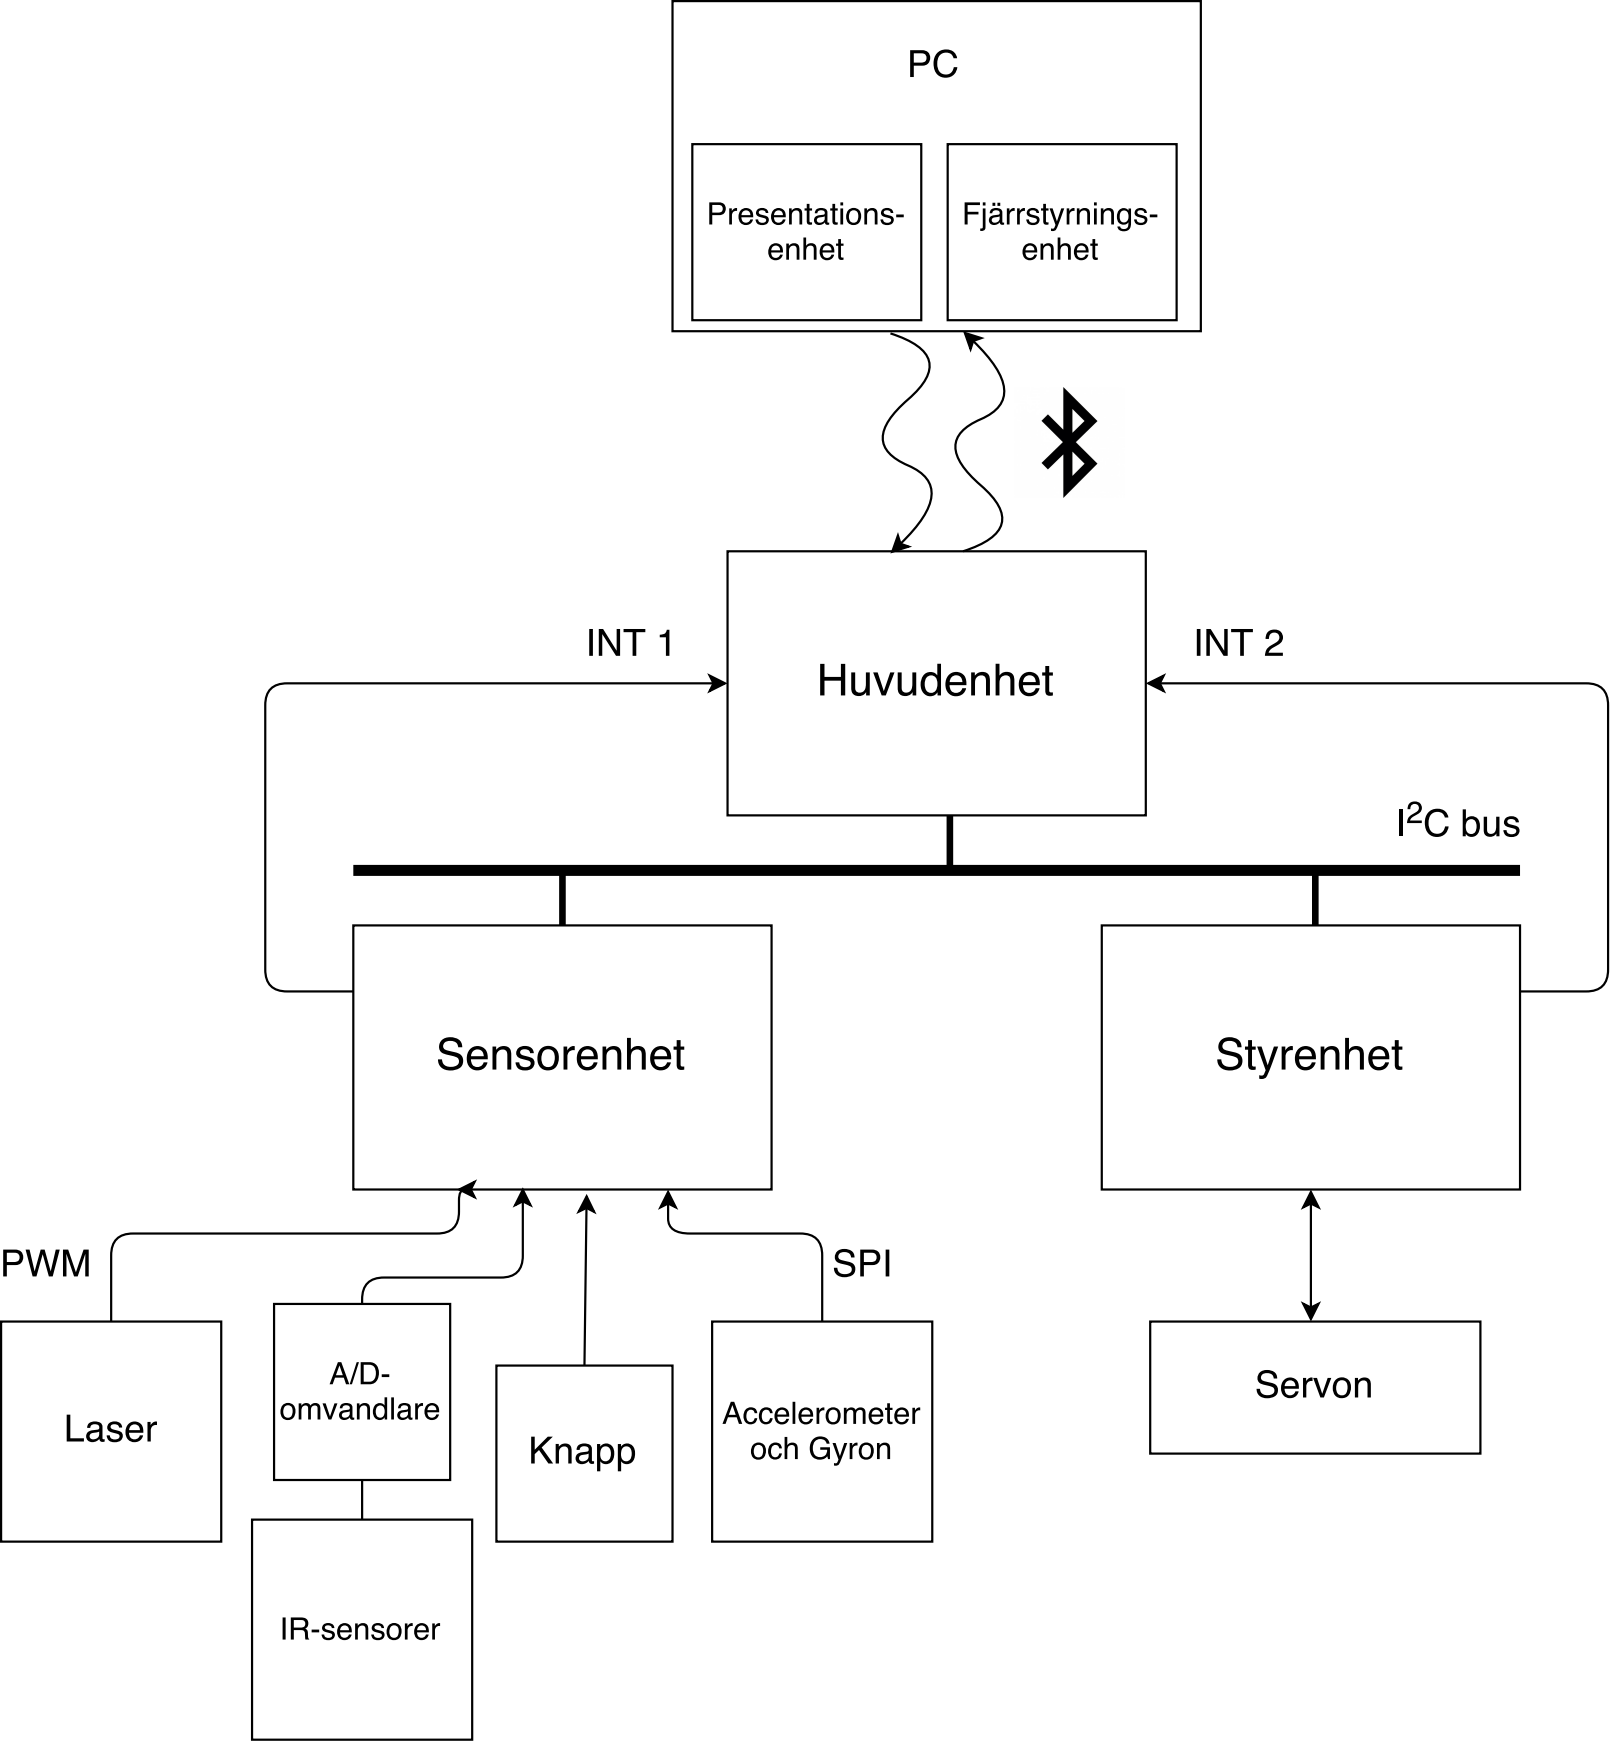
[picture p85: page 1]
