SebastianCallh/kartoffel-tsea29/docs/src/images/KartgrafLov.pdf

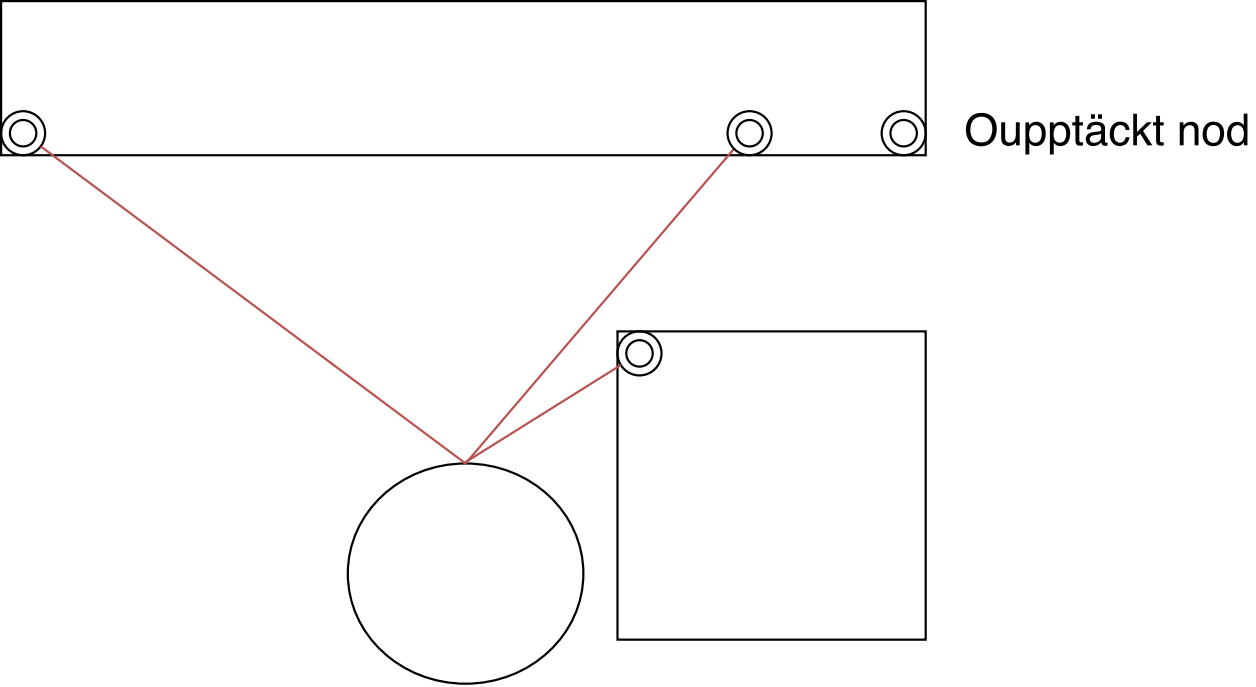
[picture p86: page 1]
