SebastianCallh/kartoffel-tsea29/docs/src/images/Bluetooth_kommunikation_i_robot.pdf

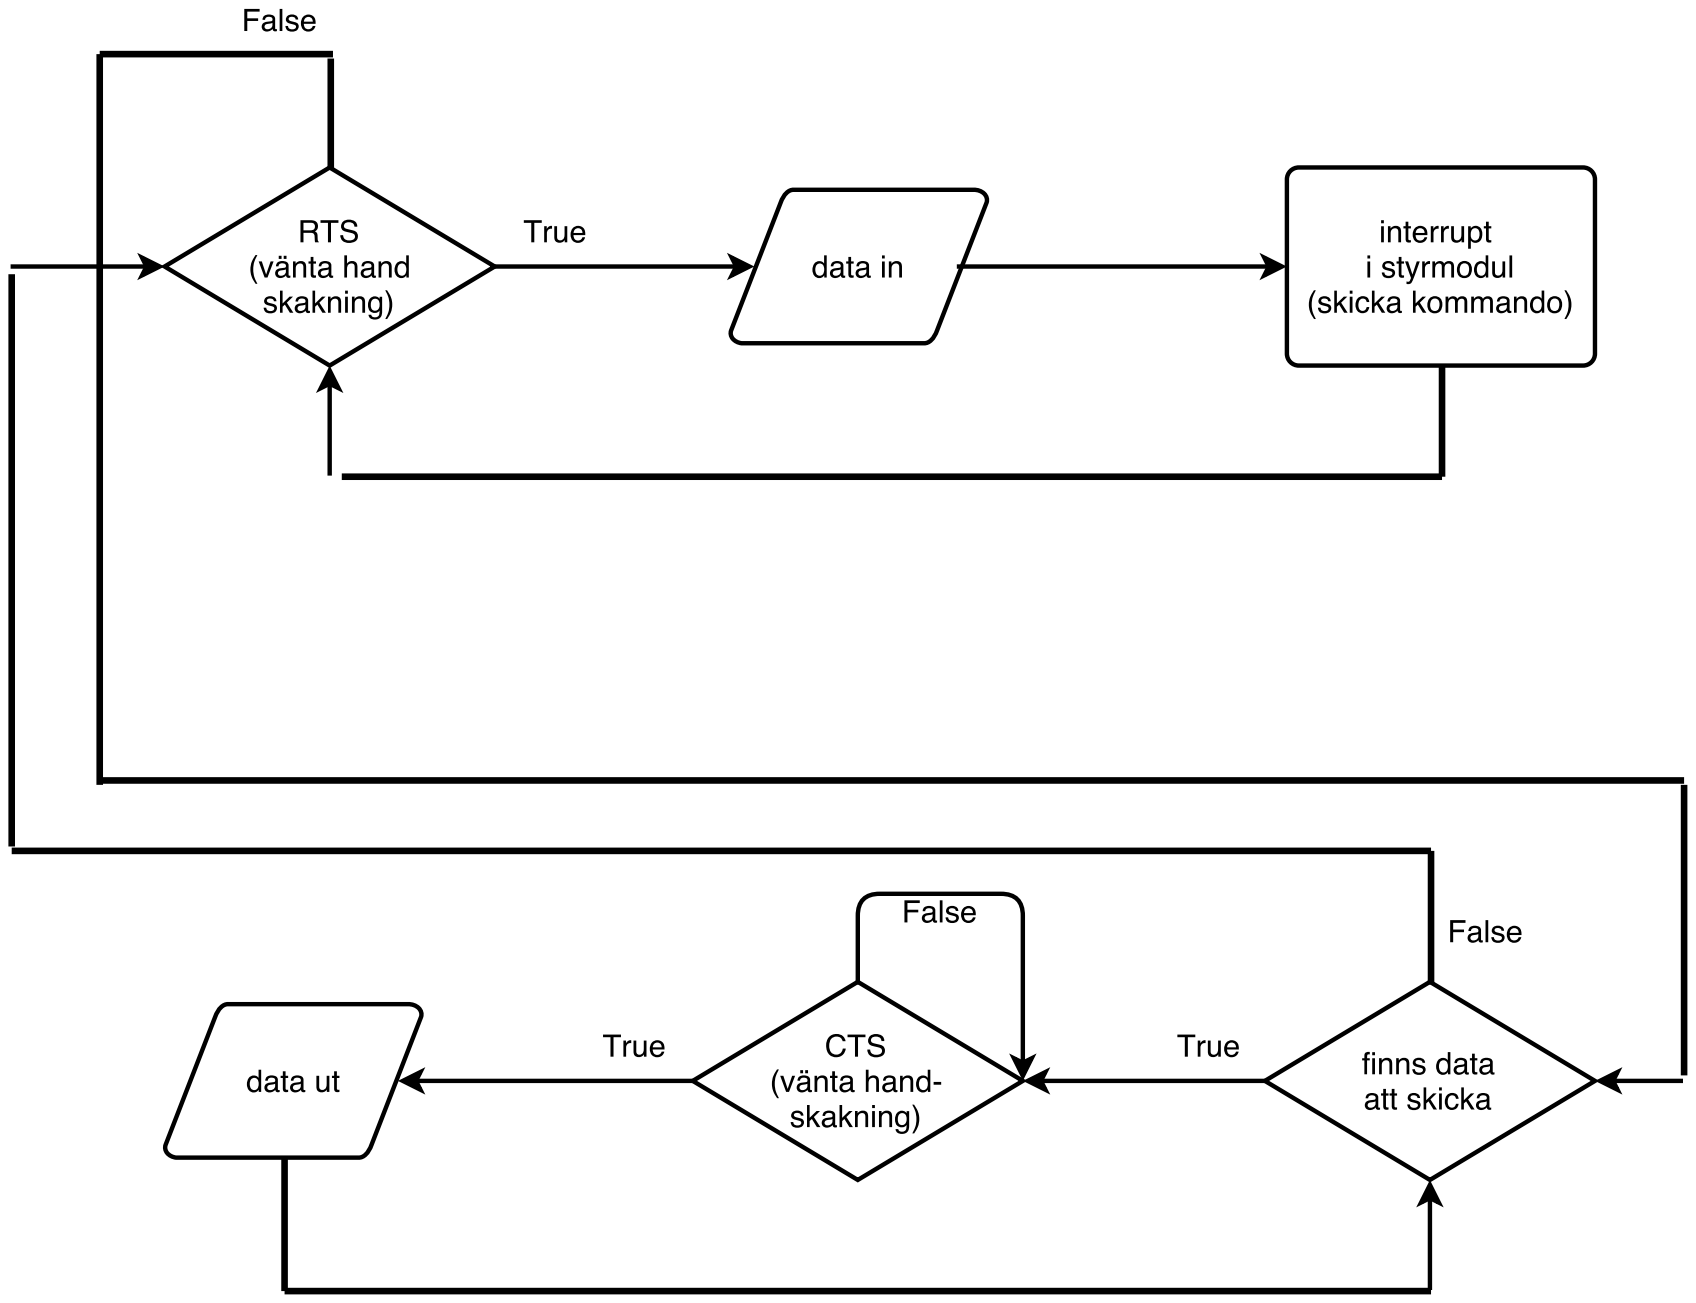
[picture p87: page 1]
