SebastianCallh/kartoffel-tsea29/docs/src/images/oversikt_systemet.pdf

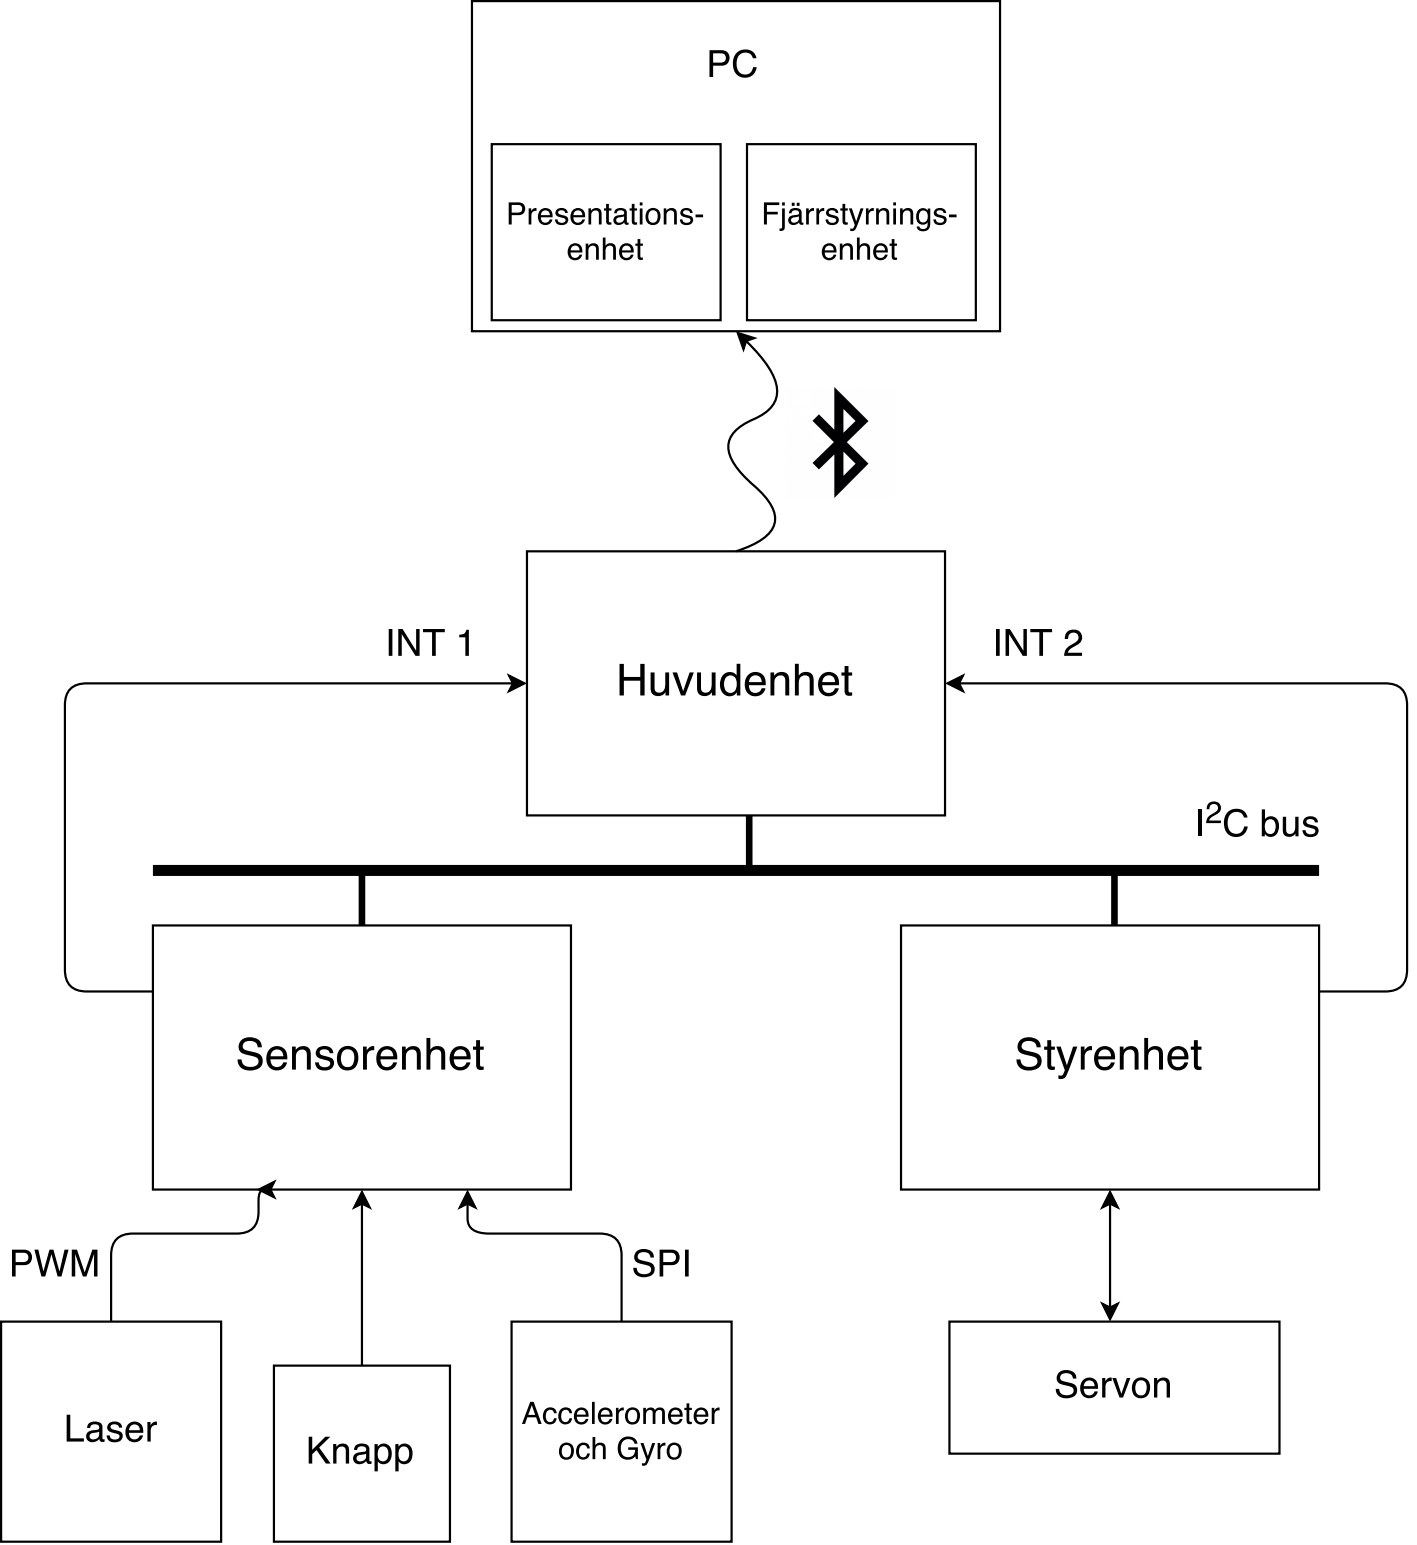
[picture p88: page 1]
