SebastianCallh/kartoffel-tsea29/docs/src/images/Koordinatberakning.pdf

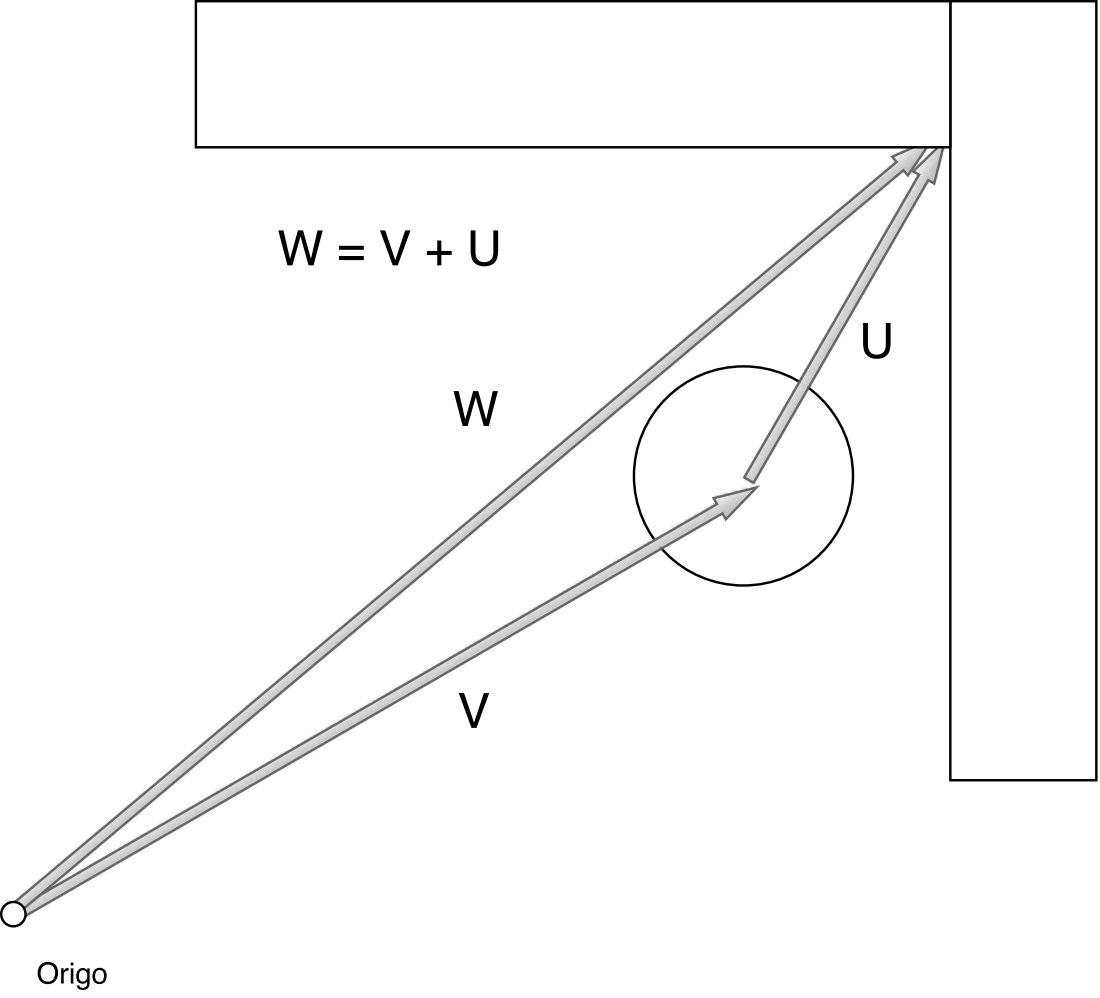
[picture p89: page 1]
