SebastianCallh/kartoffel-tsea29/avr/common/common/common/config.h

/*
 * config.h
 *
 * Created: 11/1/2016 4:00:18 PM
 *  Author: patsl736
 */ 


#ifndef CONFIG_H_
#define CONFIG_H_

// Processor frequency
#define F_CPU 16000000UL

// USART speed
#define USART_BAUDRATE 9600


#endif /* CONFIG_H_ */
