SebastianCallh/kartoffel-tsea29/avr/common/common/common/packet.h

/*
 * packet.h
 *
 * Created: 11/4/2016 3:35:21 PM
 *  Author: antda685
 */ 


#ifndef PACKET_H_
#define PACKET_H_

struct packet 
{
	unsigned char data[256];
	unsigned int size;
};



#endif /* PACKET_H_ */
