SebastianCallh/kartoffel-tsea29/avr/common/common/common/packet_parser.h

/*
 * packet_parser.h
 *
 * Created: 11/7/2016 1:23:26 PM
 *  Author: antda685
 */ 


#ifndef PACKET_PARSER_H_
#define PACKET_PARSER_H_
#include "packet.h"

void parse_and_execute(struct packet* p);



#endif /* PACKET_PARSER_H_ */
