SebastianCallh/kartoffel-tsea29/pi/accel.py

from time import sleep

import Adafruit_LSM303

lsm303 = Adafruit_LSM303.LSM303()
class Accel:

    @staticmethod
    def read_data():
        try:
            accel, mag = lsm303.read()
            accel_x, accel_y, accel_z = accel
            mag_x, mag_y, mag_z = mag
            accel_x = accel_x * 0.001 * 9.82
            if(abs(accel_x) < 0.2):
                return 0
            return accel_x
        except:
            return -1
