SebastianCallh/kartoffel-tsea29/pi/test_mapping.py

from position import Position

pos = Position(None, None, None)
pos.map_data = [(0, 0), (0, 1), (1, 1), (2, 1), (3, 1), (3, 2), (3, 3), (3, 4), (3, 5), (3, 6), (3, 7), (2, 7), (1, 7), (0, 7), (-1, 7), (-2, 7), (-2, 6), (-2, 5), (-3, 5), (-4, 5), (-5, 5), (-6, 5), (-5, 5), (-4, 5), (-4, 4), (-4, 3), (-4, 2), (-4, 1), (-3, 1), (-2, 1), (-1, 1), (0, 1), (0, 0), (3, 2), (3, 3), (2, 3), (1, 3), (0, 3), (-1, 3), (-1, 4), (-1, 5), (-1, 6), (0, 6), (1, 6), (1, 5), (1, 6), (2, 6), (3, 6), (3, 5), (3, 4), (3, 3)]
pos.edges_data = [(0, 0), (0, 1), (1, 1), (2, 1), (3, 1), (3, 2), (3, 3), (3, 4), (3, 5), (3, 6), (3, 7), (2, 7), (1, 7), (0, 7), (-1, 7), (-2, 7), (-2, 6), (-2, 5), (-3, 5), (-4, 5), (-5, 5), (-6, 5), (-5, 5), (-4, 5), (-4, 4), (-4, 3), (-4, 2), (-4, 1), (-3, 1), (-2, 1), (-1, 1), (0, 1), (0, 0)]
pos.island_data = [(1, 5), (2, 3), (-1, 5), (0, 6), (0, 5), (2, 5), (2, 4)]

pos.map_island_data()
print(pos.island_data)

pos.map_remaining_data()
print(pos.map_data)
