SebastianCallh/kartoffel-tsea29/(commit log)

2016-09-19 Added picture of Sensorenhet
2016-09-19 Added information about what sensor and the interface used to communicate with the 'sensorenhet'
2016-09-19 Added text for laser distance sensor
2016-09-19 added image of laser sensor
2016-09-19 Added subsubsection for laser mounting
2016-09-19 Minor changes to the description of sensorenhet
2016-09-19 Clarified laser rotation
2016-09-20 Removed figurerefences from 'Styrenhet' and 'Sensorenhet'
2016-09-20 Added flowchart and text about flowchart under 'Kommunikationsenhet'
2016-10-07 Made a small start on sensorenhet
2016-10-08 added flow chart presentationsenhet
2016-10-08 Kept working with sensorenhet
2016-10-09 Kept working with sensorenhet, komponenter and resurser
2016-10-09 Added component list under Styrenhet > Komponenter, added text at Styrenhet. Made minor layout changes under Sensorenhet to match the rest of the document
2016-10-10 Sensorenhet partially done, just diagrams left
2016-10-11 Added an estimate of resource usage for the sensor unit
2016-10-11 added flowcharts for sensorenhet and styrenhet
2016-10-11 Made sure all current pictures in designspecifikationen fit within the text margin
2016-10-11 Added pin resource table to 'Styrenhet'
2016-10-11 Added pin requirements for UART debugging connection
2016-10-11 Added text to Sensorenhet > Programflöde > Flowchart
2016-10-11 Added text for Styrenhet > Programflöde > Flowchart
2016-10-11 added text to huvudenhet on sweeping laser strategy
2016-10-12 Moved sensor resource motivation from styrenhet to sensorenhet
2016-10-13 Modified Huvudbuss image to include lasersensor and accelerogyro. Changed text in multiple places to include that the two previously mentioned modules are connected to the main bus and not the procce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
2016-10-18 updated flowchart for navigation to reflect rotations and not turns
2016-10-23 Added note about pull-up-resistor to main bus
2016-10-26 Modified sensorenhet to use Adafruit sensors
2016-10-26 Updated kopplingsschema sensorenhet and port list
2016-10-27 updated diagram and component lists to include JTAG and UART for styrenhet
2016-10-27 updated diagram for huvudenhet with bss138 and usb powering
2016-10-27 updated diagram for huvudenhet to have a 3.3 v node and a 5v node on the i2c bus
2016-11-02 changed IR-sensor model
2016-11-02 added map styrenhet and basic code to read from adc
2016-11-02 i2c slave started working on
2016-11-03 Implemented functionality to read from both IR sensors
2016-11-03 i2c buss working without debugability
2016-11-03 Added abillity for the robot to move. The wheel pairs can be controlled independently of each other
2016-11-04 Queue made for i2c handling
2016-11-04 I2C bus up and running
2016-11-07 built protocol for i2c bus
2016-11-07 did some work on the sensorenhet, no success
2016-11-08 i2cbus working properly
2016-11-08 Fixed reading. Increased request frequency to 1000 Hz
    [bus.py, main.py]
2016-11-08 Fixed minor int to str error
    [main.py]
2016-11-08 IR sensors working properly
2016-11-08 Added motor commands to main unit
2016-11-08 giant merge, possibility to move wheels
2016-11-08 Fixed IR sensor left/right assignments
    [sensorenhet.c]
2016-11-08 Sensorenhet integrated in project
2016-11-08 Changes for 16-bit sensor data
2016-11-08 Send sensor data in 16-bit format
2016-11-08 Convert speeds received from common motor speed command
2016-11-09 Added traceback print
2016-11-09 Fixed traceback print
2016-11-09 Fixed traceback print again, due to Pata's wrong information
    [main.py]
2016-11-09 More first try fixes for reglering
    [main.py]
2016-11-09 More first try fixes for reglering 2
    [main.py]
2016-11-09 More first try fixes for reglering 3
    [main.py]
2016-11-09 Added functionality when missing sensor data
    [main.py]
2016-11-09 Added functionality when missing sensor data 2
    [main.py]
2016-11-10 attempt send negative wheel speed
2016-11-10 Extended IR-sensor table
2016-11-10 Laser reading integrated in main
2016-11-11 changed laser read address
2016-11-11 Fixed direction error while acting on negative speeds
    [styrenhet.c]
2016-11-13 corrected TURN_SPEED in main
    [main.py]
2016-11-13 test for pin output with python3-gpio
2016-11-13 added print statements
2016-11-13 commiting comments mostly. Still broken
    [lcd.py]
2016-11-13 more pin comments
2016-11-13 fixed error in registerselect
    [lcd.py]
2016-11-13 made startup sequence shorter
    [lcd.py]
2016-11-14 first try to find device
2016-11-14 added bt test using socket
2016-11-15 self in driver methods
2016-11-15 moved globals in autocontrol�l
2016-11-15 print messages in navigator
2016-11-15 prints in driver
2016-11-15 more prints
2016-11-15 changed condition for turning to sensor value being -1
2016-11-15 print in main
2016-11-15 syntax error shorter warmup
    [main.py, navigator.py]
2016-11-15 revert to old check with 20 mm
    [navigator.py]
2016-11-15 Added prints
2016-11-15 Laser is modified
2016-11-15 Laser is return values in mm
2016-11-15 fixed print of message
2016-11-15 added error print
2016-11-15 support for laser
2016-11-15 updated main and driver to reflect new changes in bus
2016-11-15 changed method calls to bus since they were brokern
    [laser.py]
2016-11-15 commented out bork laser
2016-11-15 laser fix in navigator
    [navigator.py]
2016-11-15 driver fix in navigator
    [navigator.py]
2016-11-15 commented out laser
2016-11-16 prints in bus
2016-11-16 print in event
2016-11-16 Will test new laser code
2016-11-16 fixed silly mixup of left and right
    [navigator.py]
2016-11-16 testing laser
2016-11-16 Fixed spelling mistake in imported file
    [main.py]
2016-11-16 Address bus correctly in laser module
    [laser.py]
2016-11-16 Added simple emulation for laser
2016-11-16 Fixed handle_abort causing the robot to crash instead of shutting down safely
    [safety.py]
2016-11-16 Laser is definately working
2016-11-16 laser fix and improved navigation
    [driver.py, laser.py, navigator.py]
2016-11-16 removed prints
2016-11-16 mer bättre driver
2016-11-16 LAser updated
2016-11-16 super ad hoc test with two sensors at one side
2016-11-16 enabled laser
2016-11-16 cached laser data
2016-11-16 laser from laser branch
2016-11-16 import time in laser
2016-11-16 only one laser read
2016-11-16 laser fix and left side
    [laser.py, navigator.py]
2016-11-16 revert to right auto control
    [navigator.py]
2016-11-17 Fixed str and int concatenation
    [position.py]
2016-11-17 Implemented threading for calculating distance
2016-11-17 Implemented threading for calculating distance: removed parenthesis
2016-11-17 added gyro
2016-11-17 gyro addr
2016-11-17 two comp in gyro
2016-11-17 gyro sensitivity
2016-11-17 advanced driver yo
2016-11-17 attempt one at integrating gyro in navigation
2016-11-17 changes to driver implementation
2016-11-17 Edited what maybe a wrong function name
    [driver.py]
2016-11-17 Fixed some errors in driver.py
    [driver.py]
2016-11-17 added print in driving state
2016-11-17 Adding some prints to idle
2016-11-17 Made initiation in driver
2016-11-17 fixed init for gyro
    [gyro.py]
2016-11-18 Managed initialization for accelerometer
2016-11-18 syntax fixes and indention
    [bt_server.py, bt_server_cmds.py, bt_server_runner.py, bt_task_handler.py]
2016-11-18 Accelerometer testing
2016-11-20 don't track textfiles
2016-11-20 debug prints
2016-11-20 fixed renaming in lcd
    [lcd.py]
2016-11-20 debug prints 2
2016-11-20 debug prints 3
2016-11-20 c��lear on send
2016-11-20 better debug prints
2016-11-20 Fixed sent data formatting to utf-8
    [bt_server.py]
2016-11-20 fixed return types and default value cmd_id
    [bt_server.py, bt_task_handler.py, main.py]
2016-11-20 commented print
2016-11-20 fixed only writing to data register
    [lcd.py]
2016-11-20 fixed 0 and \n
    [lcd.py]
2016-11-20 added print of type
2016-11-20 removed print
2016-11-20 remove forever-prints
2016-11-20 remove more prints
2016-11-20 break main loop if correct is found
    [main.py]
2016-11-20 concatination of string fix
    [bt_server.py]
2016-11-20 new debug prints
2016-11-21 fixed clean files in task handler
    [bt_task_handler.py]
2016-11-21 Driver robot with distance for turns
2016-11-21 Removed old files, added error handling for memory error
    [bt_task_handler.py]
2016-11-21 print memory usage and traceback
2016-11-21 print traceback
2016-11-21 removed close log bug
    [bt_server_runner.py]
2016-11-21 fixed unresolved reference to task
    [bt_task_handler.py]
2016-11-21 fixed peek print
2016-11-21 removed loop prints
2016-11-21 Prints for remaining destination
2016-11-21 removed forever-prints, added another check if list is empty, still testing for forever filling bt_commands file
2016-11-21 Now gets memoryError when deleting first line of bt_commands. Print list of tasks to debug
2016-11-21 Print the other list of tasks to debug
2016-11-21 Fixed prints
2016-11-21 Added print in degree task
2016-11-22 Fixed errors with bus
    [bus.py]
2016-11-22 Added prints to section
2016-11-22 Syntax fixes and setting socket to close instead of shutdown
    [bt_server.py, bt_task_handler.py]
2016-11-22 added prints in main
2016-11-22 changed prints in main so no forever-prints
2016-11-22 wrong file name task handler
    [bt_task_handler.py]
2016-11-22 More prints in main, not sure if can post to answers
2016-11-22 Debug prints in post_outgoing, main is fine and getting ip as it should
2016-11-22 more prints in server
2016-11-22 change from logfile to prints in runner
2016-11-22 Added eventbus support for sensor/servo/map data requests
2016-11-22 Changed constants, switched from floor to ceiling and removed constant in section.py
2016-11-22 fixed bug in task handler where shallow copy of task obj was deleted YAY
    [bt_task_handler.py]
2016-11-22 wrong name, and run server runner immed
    [bt_server_runner.py, bt_task_handler.py]
2016-11-22 Added support for a second IR sensor
2016-11-22 Reverted support for second IR
    [main.py, navigator.py, protocol.py]
2016-11-23 uncomment laser main
2016-11-23 diasble laser init
2016-11-23 Fixed a second measure error
    [navigator.py]
2016-11-23 trying to fix list tuple conflict
    [command_processors.py]
2016-11-23 Removed a print
2016-11-23 wrong socket
2016-11-23 Not calling shutdown_server(), and fixed formatting
    [bt_server.py, bt_server_runner.py, bt_task_handler.py, eventbus.py, main.py, outbound.py, protocol.py]
2016-11-23 debug print in client
2016-11-23 Extracted client connection to a function, and fixed more debug prints not showing everytime
2016-11-23 Removed print from navigator and included print for gyro in driver
2016-11-23 In the middle of fixing proper shutdown of server, does not work right now
    [bt_server.py, bt_server_runner.py]
2016-11-23 Testing regulation with 2 sensors on the right side
2016-11-23 fixed division by zero error
    [autocontroller.py]
2016-11-23 Removed I-part of PID
2016-11-24 changed PID-regulation to include robot angle
2016-11-24 Set dist_diff to 0 if either sensor is -1
2016-11-24 Added functionality for left back and right back IR sensors (left back is far seeing, values not converted to mm)
2016-11-24 Modified main to test sensors
2016-11-24 Added new sensors to sensor_data_recived in navigator
2016-11-24 Removed prints from main, created sensor testing file which prints all sensor data + laser distance without moving the robot
2016-11-25 more debug prints
2016-11-25 Removed waiting for EOF sine server.shutdown never sends that. Also reverted has_new_incoming back to boolean instead of constants.
    [bt_server.py, bt_server_runner.py]
2016-11-25 adding socket.close after shutting down server
2016-11-25 debug prints for finding killed client socket
2016-11-25 try without getting sensor data
2016-11-25 Changed and removed wrong bt-functions in outbound. Used constants fron protocol in runner.
    [bt_server_runner.py, outbound.py]
2016-11-25 simple format for sending sensor data to client
2016-11-27 start recieving sensor data again
2016-11-27 IT WORKS, recieve sensor data, restart and shutdown bt-server
2016-11-27 more fixes for moving out bt_task
    [bt_server.py, eventbus.py, outbound.py]
2016-11-27 Added dedicated converting function for 10-80 cm IR sensor
2016-11-27 Print less frequently
2016-11-27 distance only measured by front sensor
2016-11-27 Added print
2016-11-27 Made sure it is clear which prints are in the navigator file
2016-11-27 Changed prints
2016-11-27 Changed print frequency
2016-11-27 Hopefully fixing sharp turn at outer right turn
    [autocontroller.py]
2016-11-27 Updating sensor values more often
2016-11-27 Added task print
2016-11-27 Removed print, restored pre_turn_distance
2016-11-27 Attempted to reset Driver.task after DegreeTask
    [driver.py]
2016-11-27 Moved task reset to outer_turn_right in Driver class
    [driver.py]
2016-11-27 Restored post turn distance, added print
2016-11-27 Added thoughts on why the post_turn distance is sometimes wrong
    [driver.py]
2016-11-28 Starting commenting and removing prints. Merging to main.
2016-11-28 Added prints in driver, restored autocontroller
2016-11-28 Fixed faulty print
2016-11-28 Checking that the diff is correct for right turns
    [navigator.py]
2016-11-28 Commented functions, renamed some varibles and removed unneccesary prints
2016-11-28 Merge branches 'master' and 'newnavigation' of https://github.com/SebastianCallh/kartoffel-tsea29 into newnavigation
    # Conflicts:
    # pi/main.py
    Merged and added prints
2016-11-28 Moved IR readings to a file named IR. Changed all classes to save its current values so bluetooth can get all data from these classes. Nothing is tested.
2016-11-28 some refactoring, fixing and renaming
    [bluetooth.py, bt_server_cmds.py, driver.py, ir.py, main.py, outbound.py, protocol.py, utils.py]
2016-11-29 Added prints in Position
2016-11-29 Distance measured by laser must be greater than 50 to be added as a sample
2016-11-29 Makes sure it doesn't miss right turns (hopefully)
    [navigator.py]
2016-11-29 Changed position laser readings
2016-11-29 Removed prints, changed position calculation
2016-11-30 Fixing syntax errors and starting to fix global queues.
    [eventbus.py]
2016-11-30 Changed conflicting file name, fixing syntax errors and import misses
    [bt_data_handler.py, ir.py, main.py, utils.py]
2016-11-30 getting code for more sensors, after igoring idiotic extreme merge
2016-12-01 Updated test_sensors for non static laser
2016-12-01 rearranged gui with frames and added funcs with only prints for drive forward and back
2016-12-01 gui layout done for now and listboxes correctly updating data when full,all sizes except listbox height only dependent on main window size,buttons are bound to outbound funcs only to print
    [outbound.py]
2016-12-02 Fixed formatting and listening to keyboard
    [outbound.py]
2016-12-02 corrected subscription to communicator instead of driver
    [main.py]
2016-12-02 debug prints for driving forward
2016-12-02 Another debug print in driver when setting motor speed
2016-12-02 added restart button in gui, works, and proper shutdown at press on X window which succesfully shutdown server as well as gui window
2016-12-04 added a start for användarhandledning̈́
2016-12-04 Added debug for only laser readings
2016-12-04 Added brackets
2016-12-05 Implementedoffset in map drawing. Start point in middle of canvas and enough space for room to grow in any direction. Changed how map data is sent from communicator. Changed gui to issue server-resta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
    [outbound.py]
2016-12-05 Added calculations for mapdata and print for coordinates
2016-12-05 Position is currently working and is able to send mapdata and request current position
2016-12-05 added forward left and forward right buttons in gui
2016-12-05 updated protocol and navigator/driver logic for remote control
2016-12-05 some renaming and protocol constant binding for remote control
    [communicator.py, driver.py, main.py]
2016-12-05 updated figure for sensorenhet
2016-12-05 fixed syntax. Sorry for spmaming master <3
    [navigator.py]
2016-12-05 fixed some bad merges in driver
    [driver.py, outbound.py]
2016-12-06 fixed errors in figur efor sensorenhet
2016-12-06 updated diagrams and text for styrenhet, sensorenhet in teknisk dokumentation
2016-12-06 Changed keyand button bind functions. Button now call the outbound functions several times on one click, and key press one time. A min time between events has been set and out queue max size doubled.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
2016-12-06 fixing forward left and forward right
    [driver.py]
2016-12-06 runs navigator, remove prints remove old todo
2016-12-06 fixed forgotten name changes in client, and removed ugly prints on robot
    [driver.py, outbound.py]
2016-12-06 removed prints in bt client
2016-12-06 added print for temporary kitchens
2016-12-06 added print for ending a kitchen search
2016-12-06 added print for starting kitchen search
2016-12-06 Added print for saving kitchen
2016-12-06 Added print for calculating kitchen
2016-12-07 finished layout and radio button functionality in gui
2016-12-07 IT WORKS! Robot can send map data and client can draw it, robot can be remote controlled. Fixes: smaller time delta for remote control, less prints in client.
    [driver.py]
2016-12-07 fixed merge fixes, like name of constants in protocol
    [main.py]
2016-12-07 fixes for not receiving data
    [bt_server.py]
2016-12-08 Rewrote some wrong code
    [position.py]
2016-12-08 Removed threading
2016-12-08 Added print for section max and kitchen max
2016-12-08 Added sampling for laser data to kitchensections
2016-12-08 Added if statement for not saving blocks with distance shorter than 1
    [position.py]
2016-12-08 Added print for back sensor
2016-12-08 Added print in main for testing ir values
2016-12-09 Added ifstatement to skip 100 first measurements of IR back to reduce noise in detecting kitchen island
    [position.py]
2016-12-09 added print for kitchen start x,y
2016-12-09 Changed 10-80 cm IR sensor conversion from cm to mm
2016-12-10 Minor corrections to Sensorenhet
2016-12-10 Wrote about I2C
2016-12-11 Updated C code for sensorenhet to support button sn trigger
2016-12-11 Added fix for transforming mapdata
    [position.py]
2016-12-12 added text for paragraph Driver
2016-12-12 Revert "Save section in following island state"
    This reverts commit c8c517e94f17d9548b7f9be42cdec7a887bd2a80.
    [position.py]
2016-12-13 Corrected command and expected output for I2C debugging
2016-12-13 Removed PWM subsection
2016-12-13 added values to low pass filter in figure for sensorenhet
2016-12-13 Debug laser data to file
2016-12-13 Added bluetooth flowcharts
2016-12-13 Fixed wrong print text
    [section.py]
2016-12-13 Changed previous bluetooth flowcharts, added another bluetooth flowchart
2016-12-13 Correct rotation degree from current rotation
    [driver.py]
2016-12-13 Convert to degrees before using current angle for correction
    [driver.py]
2016-12-13 Correct rotation the other direction
    [driver.py]
2016-12-13 Reset autocontroller.lastdiff after every inner left turn
    [driver.py]
2016-12-13 Ignore unreasonable laser distances
2016-12-13 Replaced island detection algorithm
    [position.py, section.py]
2016-12-13 Prettier print of kitchen mappings
2016-12-13 Added simple filtering for IR values in position
2016-12-13 Save correct kitchen start coordinates
    [position.py]
2016-12-13 Added correction for outer right turns as well
    [autocontroller.py, driver.py]
2016-12-13 Added debug prints for right turns
2016-12-13 Also print last_valid_diff
2016-12-13 Use a previous last_valid_diff because of measurement issues
    [autocontroller.py]
2016-12-13 Fixed faulty queue logic
    [autocontroller.py]
2016-12-14 Removed unnecceary prints in client
2016-12-14 added explaination of PWM
2016-12-14 Fixed errors in I2C section
2016-12-14 Text and images added for software client, and bt flowcharts images added.
2016-12-14 Fixed paragraph error in Sensorenhet
2016-12-14 fixed figure for sensorenhet
2016-12-14 added tabletext for sensorenhet
2016-12-15 Print data after island is mapped
2016-12-15 Use correct data for mapping island
    [position.py]
2016-12-15 Fixed mapping of remaining map
    [position.py, test_mapping.py]
2016-12-15 added delta limit to laser values
2016-12-15 added filter for several laser masurements in laser
2016-12-15 Reverted autocontroller distance to wall
    [autocontroller.py]
2016-12-15 Speed/angle changes to Stabilize
    [navigator.py]
2016-12-15 Use slowest speed for Stabilize all the time
    [navigator.py]
2016-12-15 Fixed integer cast (Seba was right)
    [navigator.py]
2016-12-15 Use slightly faster speed for Stabilize
    [navigator.py]
2016-12-15 Further increase rotation speed for Stabilize
    [navigator.py]
2016-12-15 Debug filtered laser data on web server
2016-12-15 Correctly filter multiple bad laser values
    [laser.py]
2016-12-15 Even faster rotation speed for Stabilize
    [navigator.py]
2016-12-15 Fixed strange logic in laser
    [laser.py]
2016-12-15 Removed filtering of laser values in Section
2016-12-15 Use third point for laser filtering
2016-12-15 fixed problem with writing servo data
2016-12-15 Fixed state toggle via button
    [main.py, protocol.py]
2016-12-17 fixed errors that occured with position/master merge. Mode constants name i protocol -BT prefix and added is_connected decl. in bt_client
    [protocol.py]
2016-12-18 fixed logic ignoring stabilize state
    [navigator.py]
2016-12-18 laser now filters all values not smaller
2016-12-18 fixes for laser
2016-12-19 Test new laser filtering
